Purdbull/Studienarbeit/Abschlussbild.png

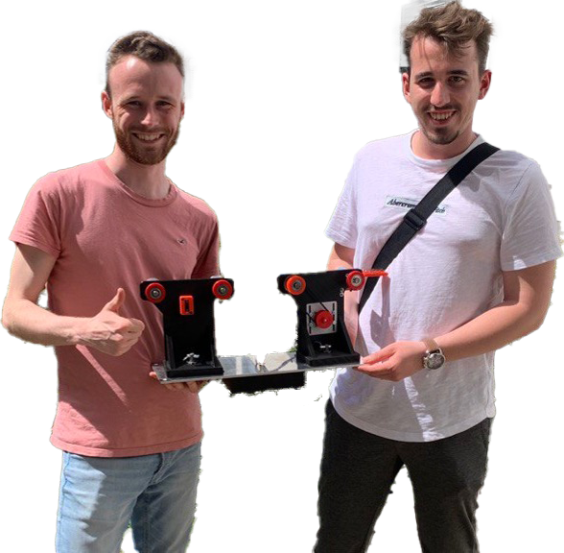
Abschlussbild.png
