Purdbull/Studienarbeit/PlakatStudienarbeitGartenhochbahn.pptx

Jan Bantle, Moritz Knapp

Bachelor – Studiengang
Mechatronik

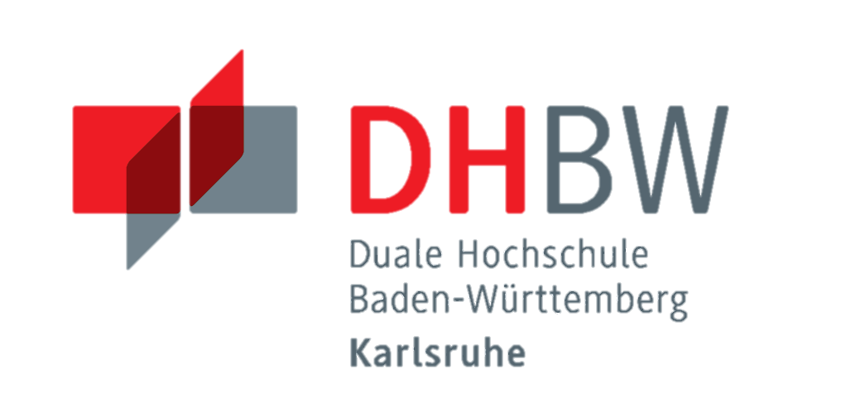
[picture p2: figure]

Digitalisierung einer Gartenhochbahn

Interdisziplinäre Studienarbeit: mechatronics meets informatics

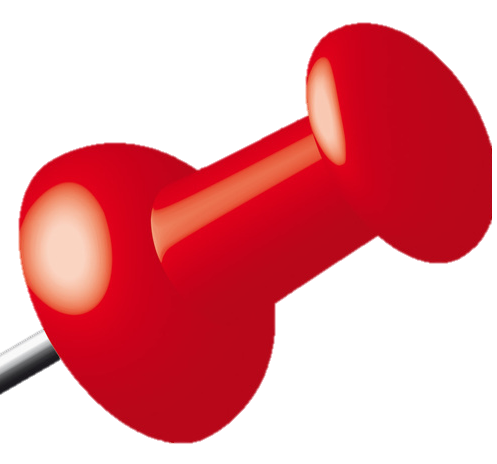
[picture p3: figure]
Alco reißnagel 1 cm Stahl rot 40 Stück

- Stromversorgung über Li-Ion-Batterie mit automatisiertem Lademanagement
- Antrieb mit Schrittmotor macht präzise Fahrprofile sowie Open-Loop-Regelung möglich
- Steuerung der Hochbahn über Webserver mit GUI
- Algorithmus zur streckenabhängigen Geschwindigkeitsregelung
- Überwachung von Warn- und Schutzfeld führt zu dynamischer Geschwindigkeitsanpassung

Highlights

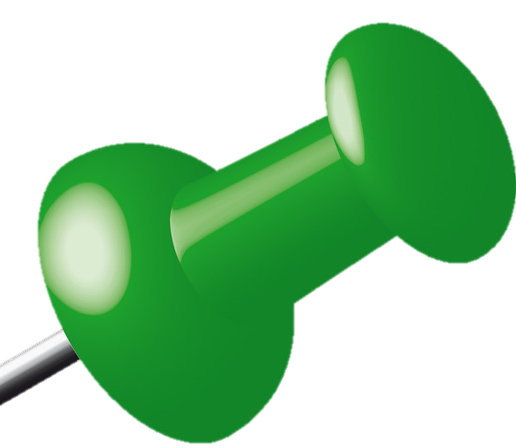
[picture p4: figure]
Alco reißnagel 1 cm Stahl grün 40 Stück

Sensorik & Aktorik

Positionserfassung & Distanzmessung

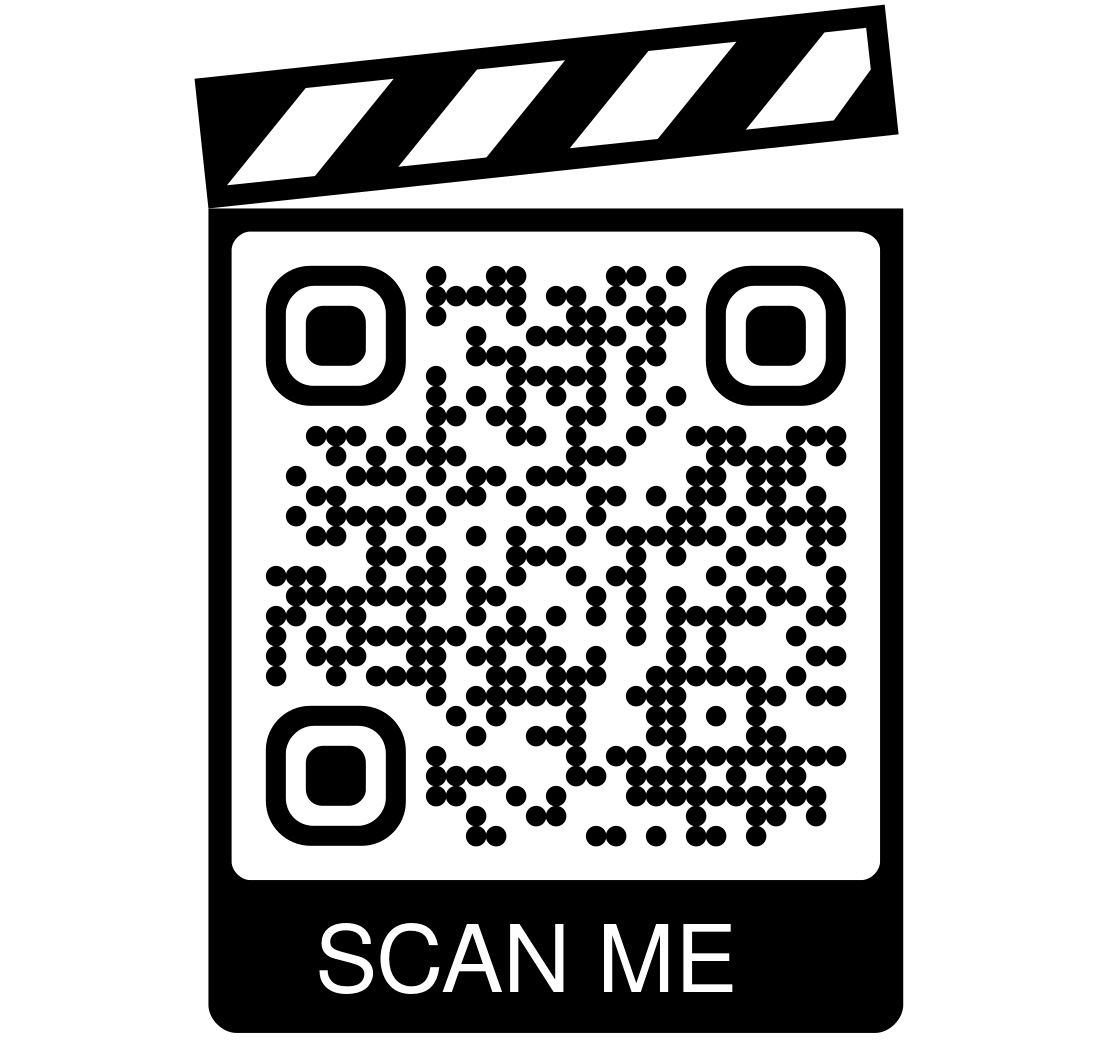
[picture p5: figure]
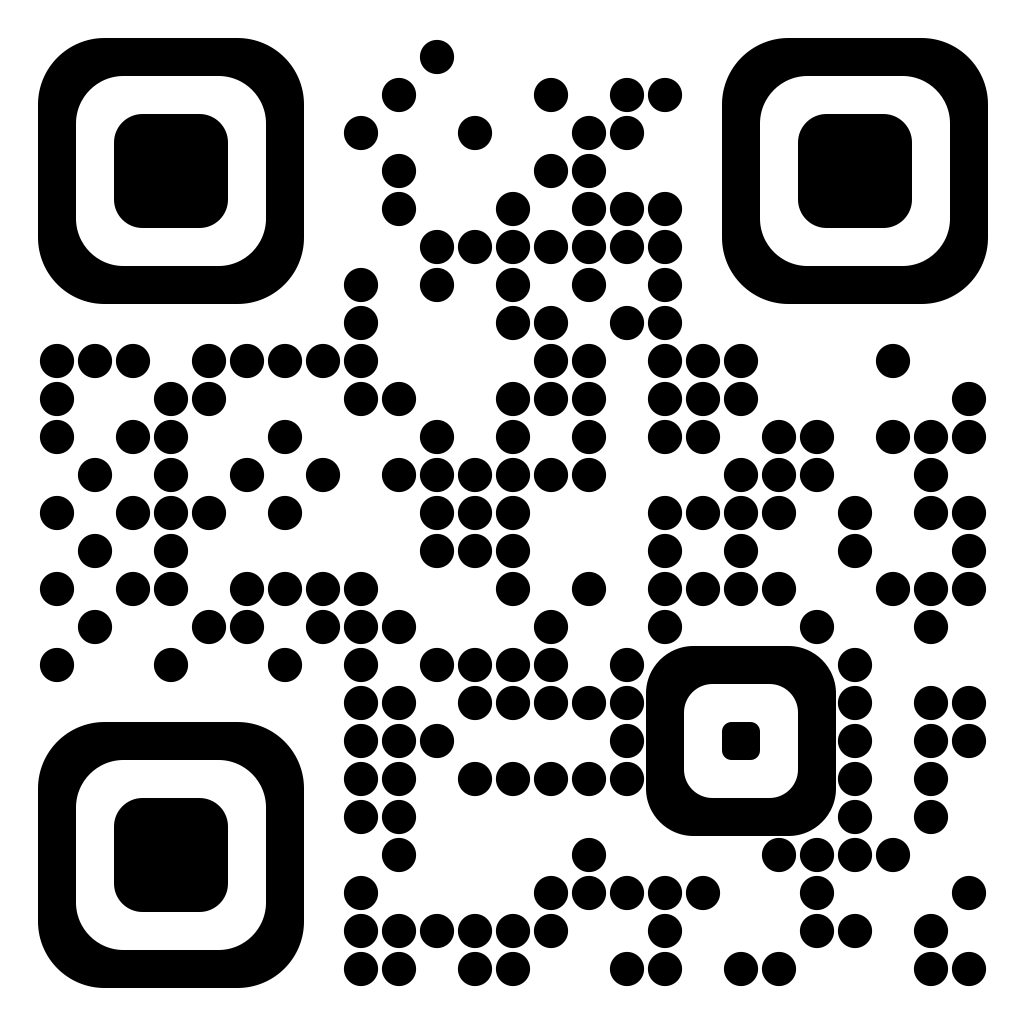
[picture p6: figure]
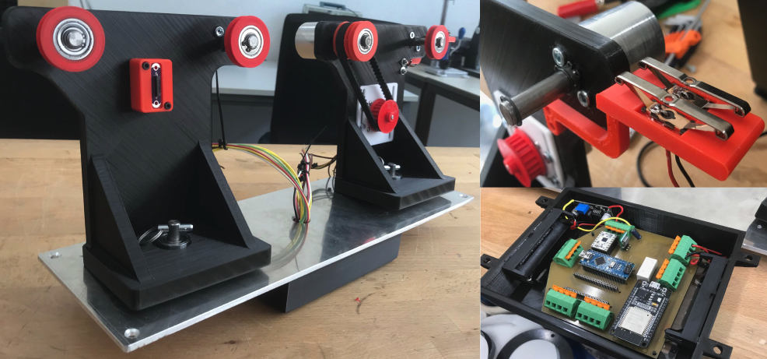
[picture p7: figure]

Erzeugen eines PWM-Signals über das Interrupt-Timer Register

Schrittmotorsteuerung

Mithilfe eines Reed-Kontakts werden Magnete entlang der Bahn erfasst.

Ein ausgelagerter Controller wertet die Signale der Ultraschallsensoren aus

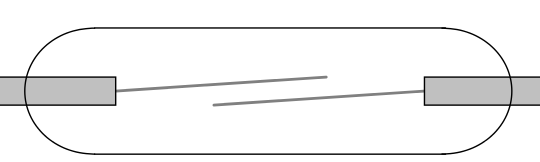
[picture p8: figure]
Der Strippenstrolch - Der Reedkontakt
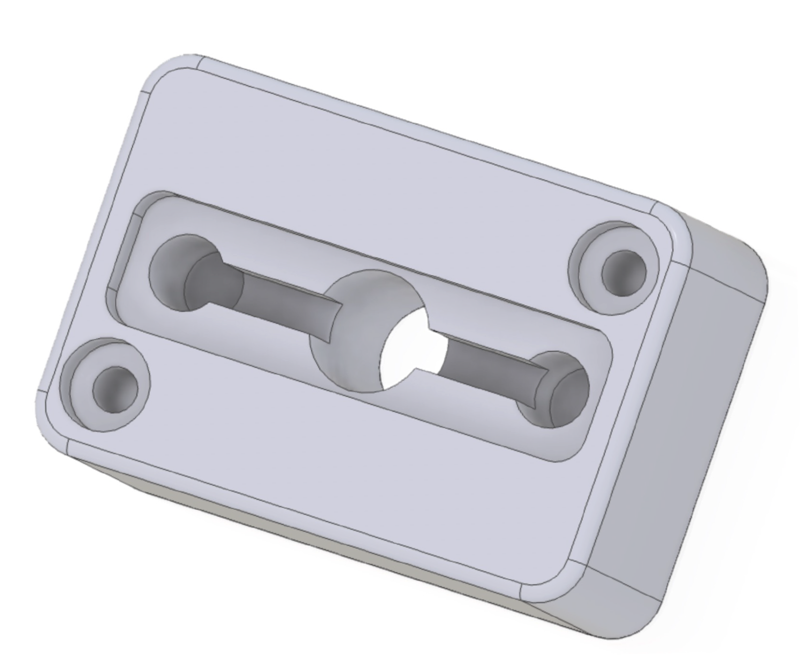
[picture p9: figure]
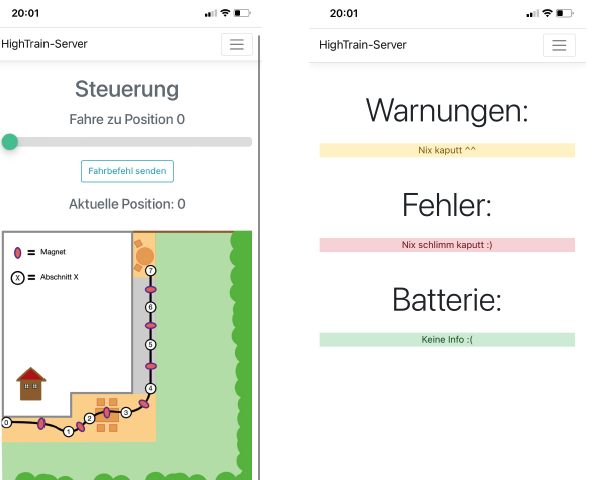
[picture p10: figure]

Grafische Benutzeroberfläche

Software

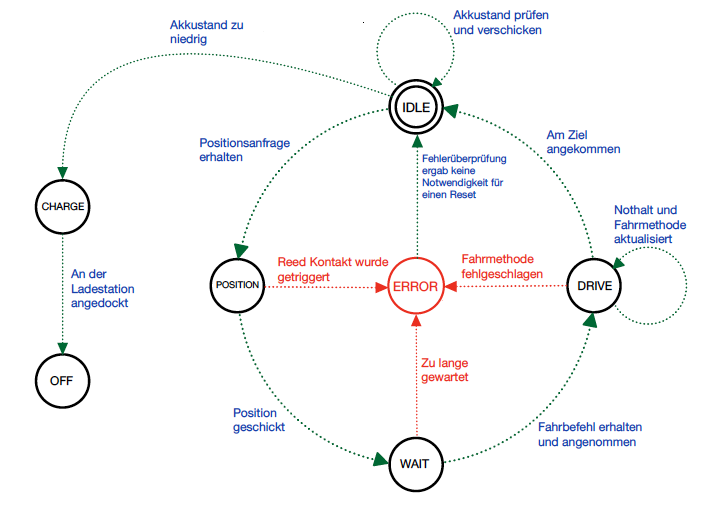
[picture p11: figure]

Zustandsautomat Hauptsteuerung

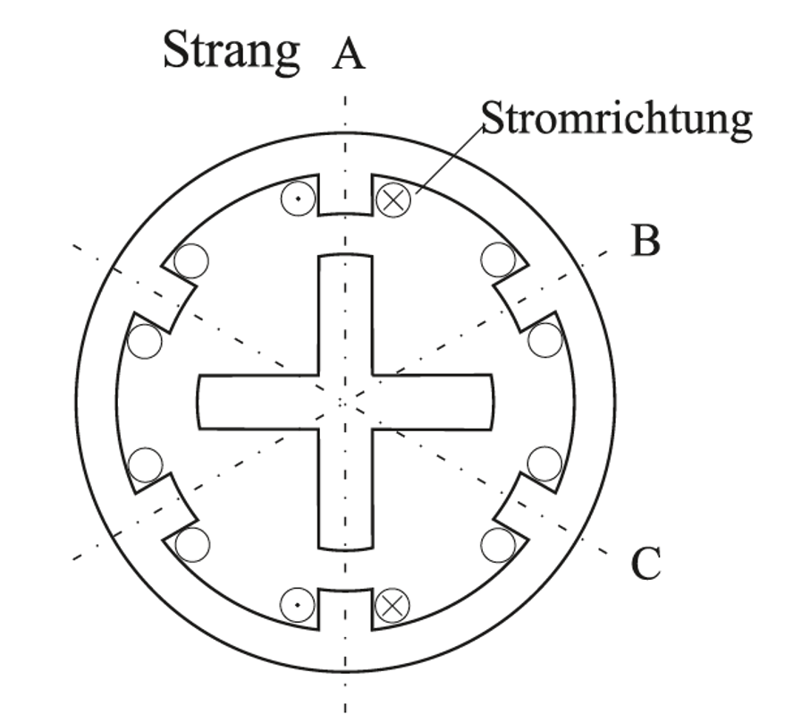
[picture p12: figure]
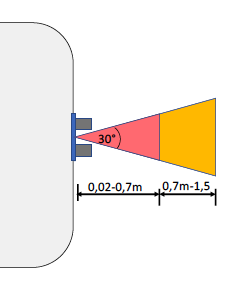
[picture p13: figure]

Betreuer
Dominik Weickgenannt

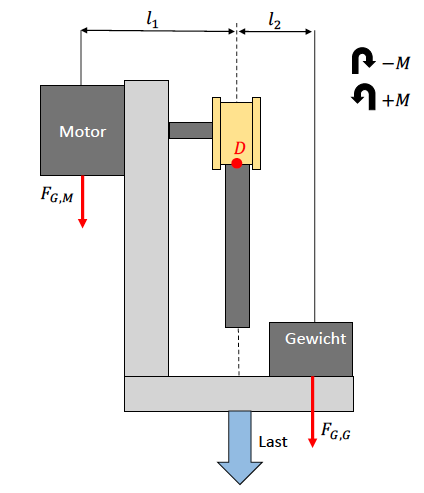
[picture p14: figure]

Konzeptionierung

Mechanik

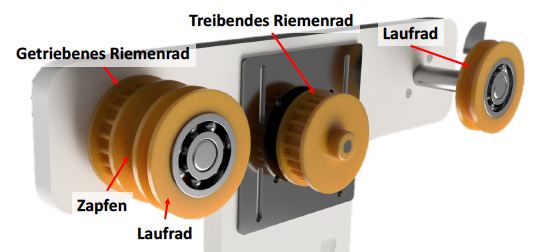
[picture p15: figure]

Fertigung

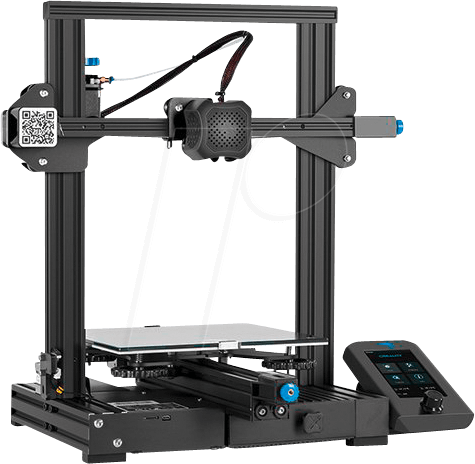
[picture p16: figure]

zerspanend

Schnittstellen

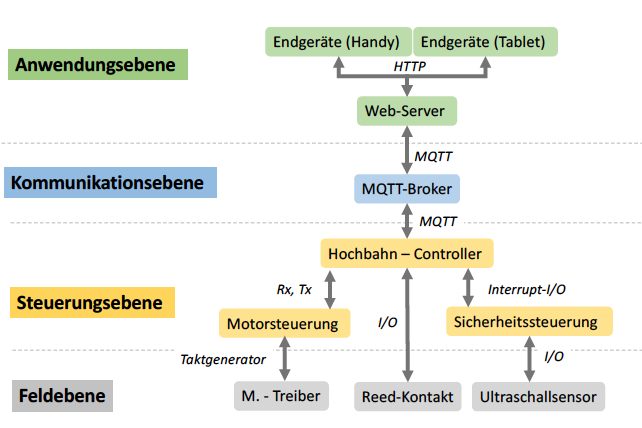
[picture p17: figure]
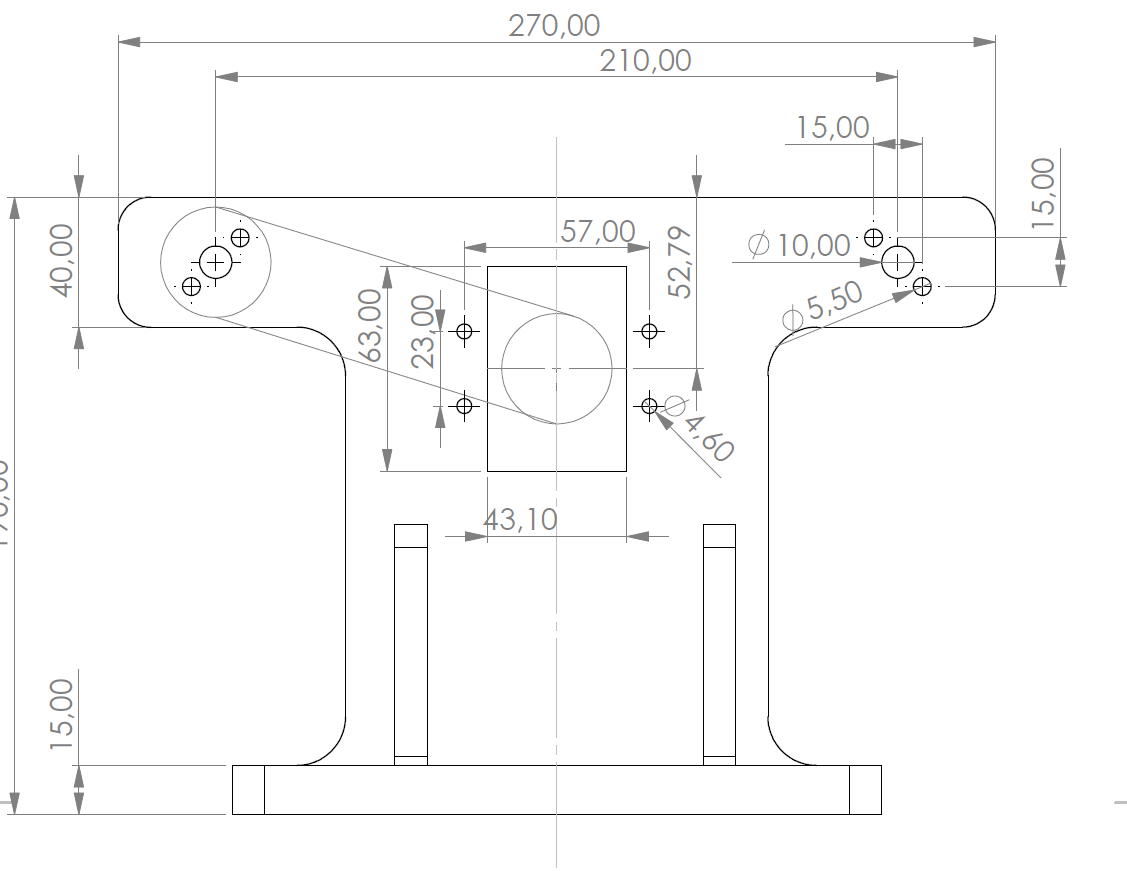
[picture p18: figure]

CAD - Entwurf

additiv

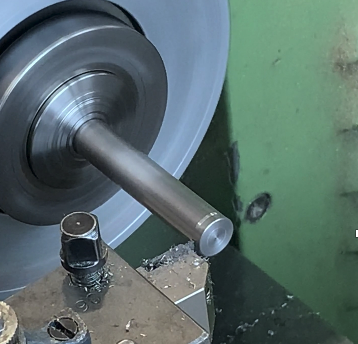
[picture p19: figure]

Fakultät

Technik

02.06.2022
