Purdbull/Studienarbeit/0_Projektorga/MeetingWeickgenannt_04_06.pptx

## Meeting Gartenhochbahn

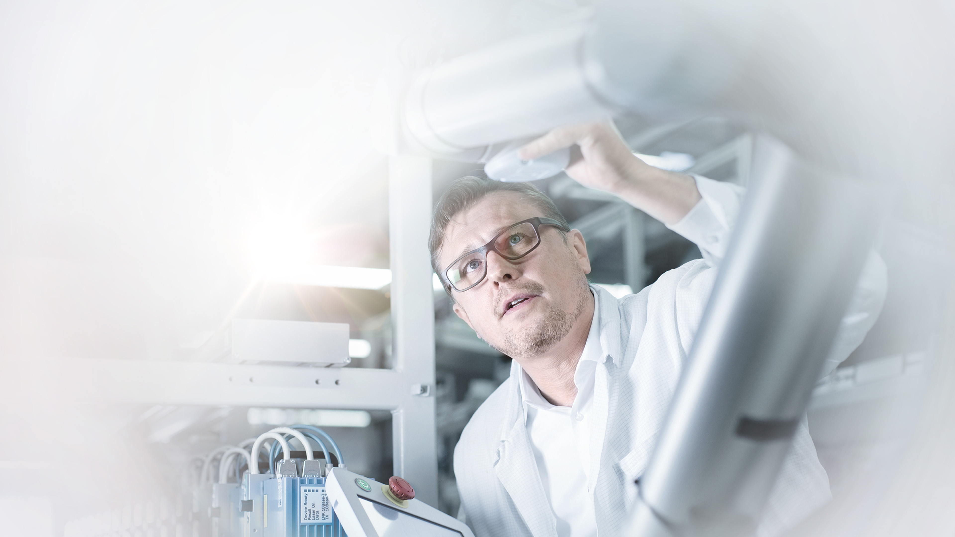
[picture p20: figure]

Moritz Knapp, Jan Bantle
05.04.2022

## 1. Entwicklung der Motor-Library

Interrupt

Counter

Vergleichs-register

f

+

Interrupt

Main loop{
}

Interrupt

## 2. Entwicklung der Fahrfunktion

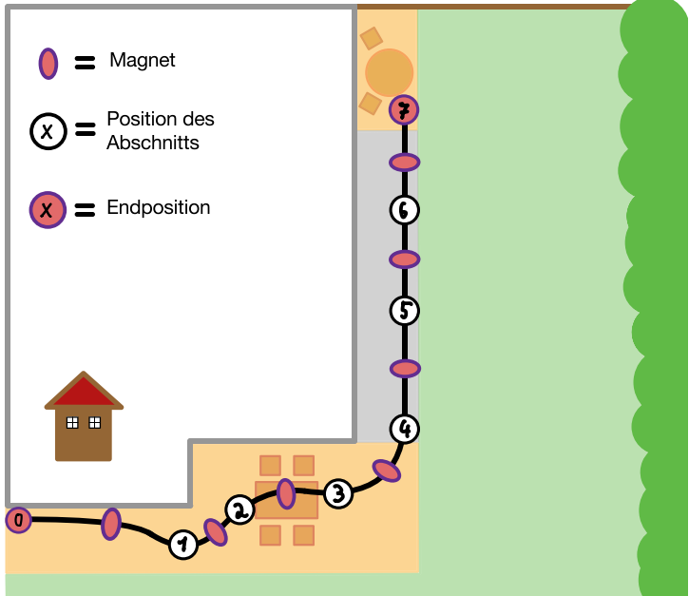
[picture p21: figure]

  - Für eine Fahrt von X nach Y gilt:
    - Die Geschwindigkeit in Abschnitt Y = 0
    - Die Geschwindigkeit im vorletzten Abschnitt max. 50%
    - Die Geschwindigkeit in Abschnitt X max. die Geschwindigkeit des 2. Abschnitts
    - Die restlichen Abschnitte ihre vordefinierte Geschwindigkeit

## Vielen Dank für Ihre Aufmerksamkeit.
