Purdbull/Studienarbeit/0_Projektorga/MeetingWeickgenannt_03_07.pptx

## Meeting Gartenhochbahn


Moritz Knapp, Jan Bantle
07.03.2022

## 1. Live-Demo: Informatik-Teil

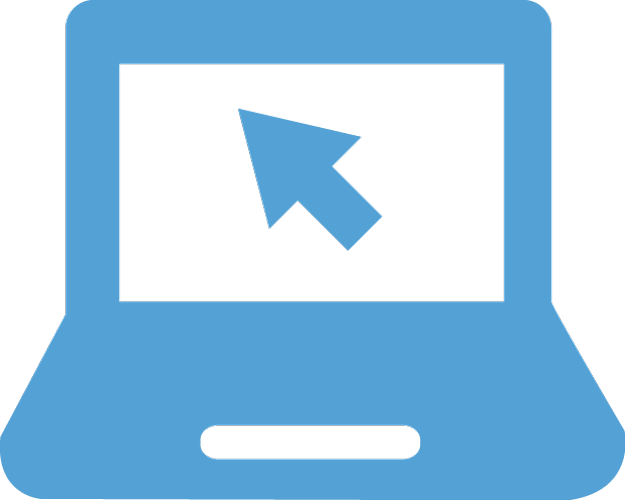
[picture p22: figure]

## Slide 3

2. Mechanischer Aufbau

- Elektronikbox
  - Konstruktion und Fertigung
- Unterbodenplatte und Drehgelenk
  - Konstruktion und Fertigung

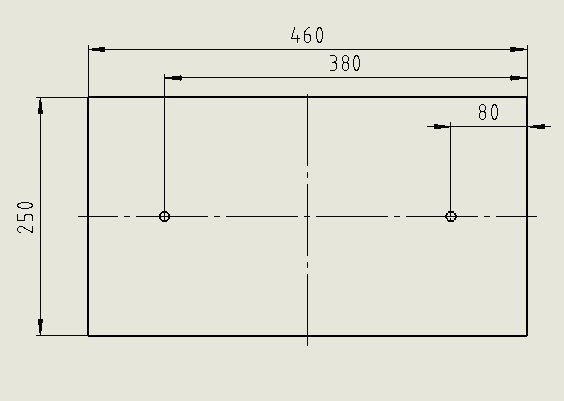
[picture p23: figure]
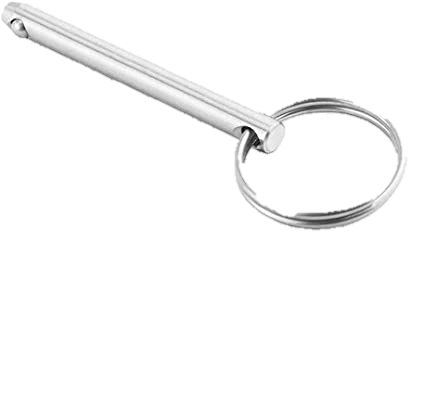
[picture p24: figure]
2 Pcs. Universal Steckbolzen mit Kugelsicherung, 316 Edelstahl : Amazon.de: Sport &amp;amp; Freizeit

Steckbolzen

Unterbodenplatte

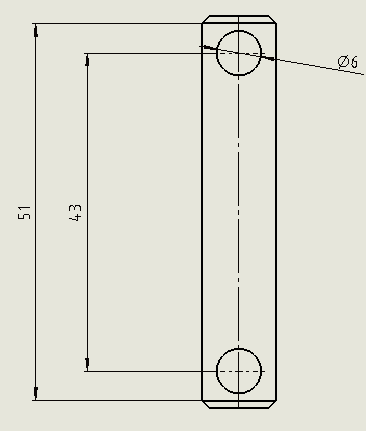
[picture p25: figure]
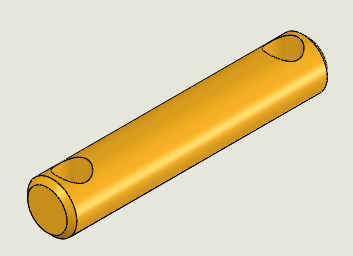
[picture p26: figure]

Gelenkbolzen

## Slide 4

2. Mechanischer Aufbau

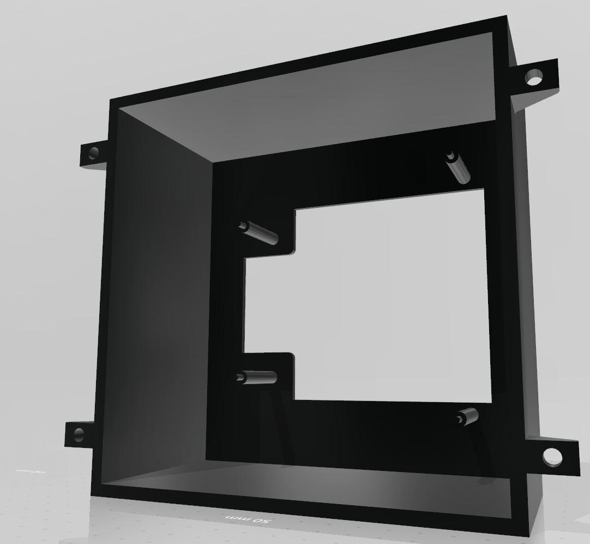
[picture p27: figure]

- Elektronikbox
  - Konstruktion und Fertigung
- Unterbodenplatte und Drehgelenk
  - Konstruktion und Fertigung

Befestigungsbolzen für Platine

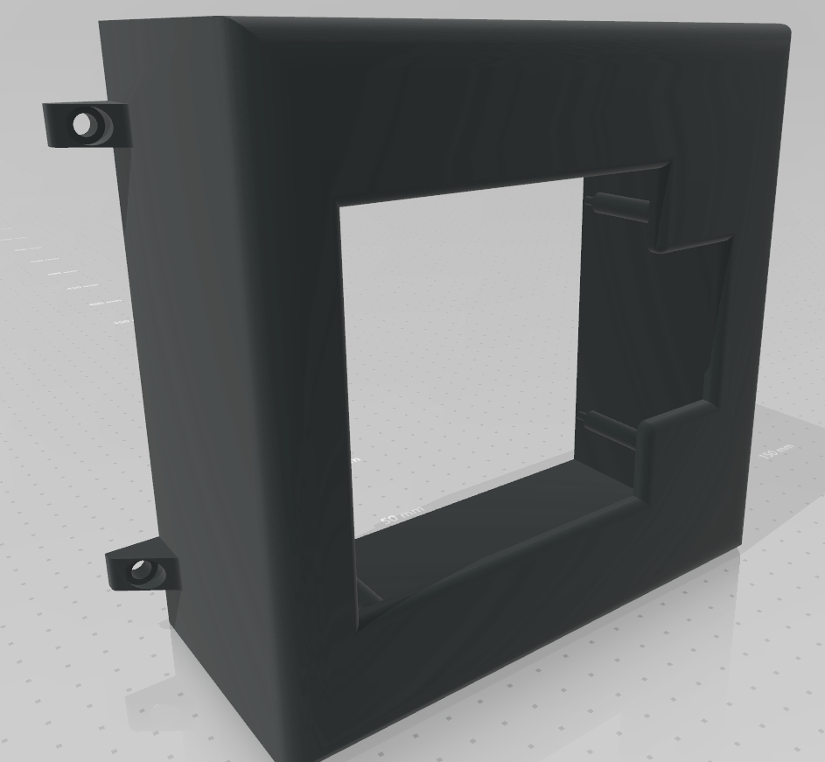
[picture p28: figure]

Plexiglas-Aussparung

Elektronikbox

## Slide 5

3. Motorsteuerung

- Schreiben eigener Stepper Library
  - Stepper-Takt über interne Arduino Timer
  - Inputsignal: speed (+/-) [%]
    - Automatisierte Beschleunigungskurve durch die Library
    - Bei 0%: Automatisiertes Wechseln über Voll- Halb und Viertelschritt → Für kontrollierten Stillstand (Lade- oder Übergabestation)
  - Weitere Funktion: EmergencyBrake

## Vielen Dank für Ihre Aufmerksamkeit.
