Purdbull/Studienarbeit/0_Projektorga/MeetingWeickgenannt_02_07.pptx

## Meeting Gartenhochbahn


Moritz Knapp, Jan Bantle
07.02.2022

## Slide 2

1. Mechanischer Aufbau

- Seitenteil
  - Anpassung der Maße an neue Riemenlänge
  - Additive Fertigung der Motofaufhängung
  - Additive Fertigung eines Prototypen
- Fertigung der Wellenaufnahme
- Neues Konzept für die axiale Fixierung der Welle
  - Fertigung der Wellen

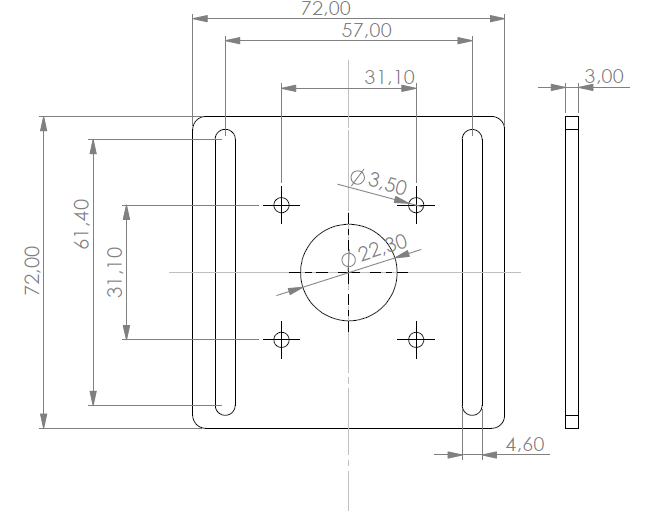
[picture p49: figure]

Seitenteil

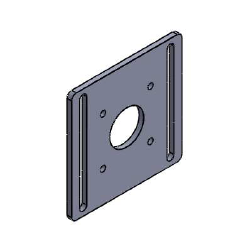
[picture p50: figure]

Motorbefestigung

## Slide 3

1. Mechanischer Aufbau

- Seitenteil
  - Anpassung der Maße an neue Riemenlänge
  - Additive Fertigung eines Prototpen
- Fertigung der Wellenaufnahme
- Neues Konzept für die axiale Fixierung der Welle
  - Fertigung der Wellen

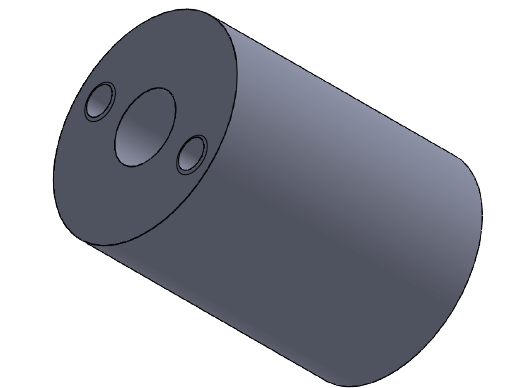
[picture p51: figure]
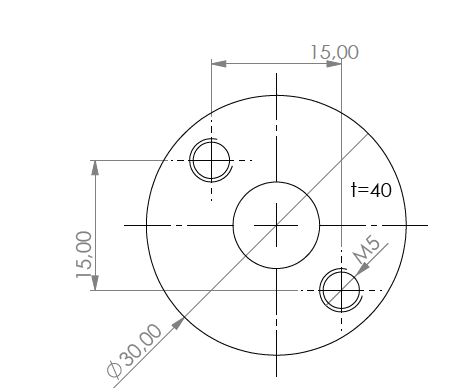
[picture p52: figure]

## Slide 4

1. Mechanischer Aufbau

- Seitenteil
  - Anpassung der Maße an neue Riemenlänge
  - Additive Fertigung eines Prototpen
- Fertigung der Wellenaufnahme
- Neues Konzept für die axiale Fixierung der Welle
  - Fertigung der Wellen

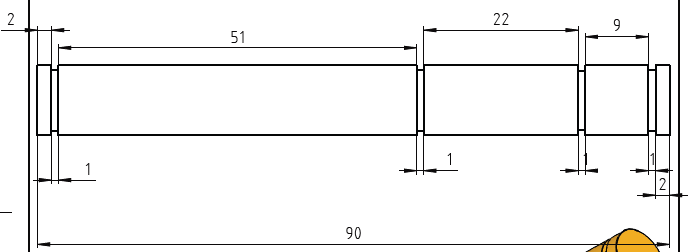
[picture p53: figure]
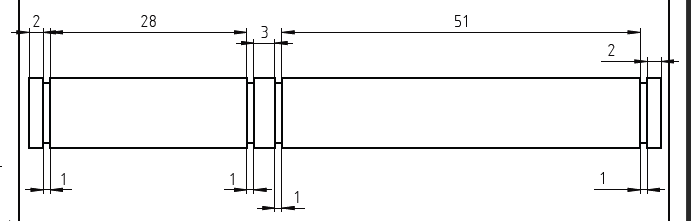
[picture p54: figure]
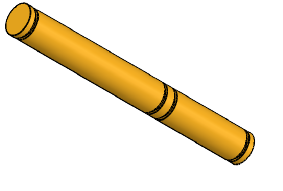
[picture p55: figure]
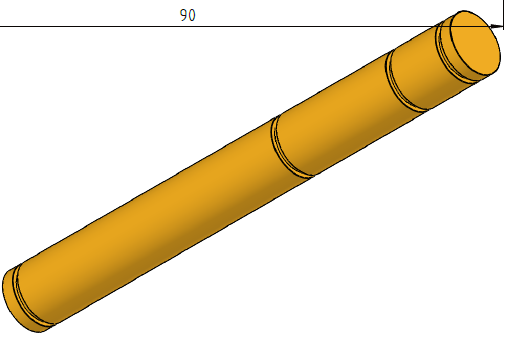
[picture p56: figure]
