Purdbull/Studienarbeit/2_CAD/Konzept I/3D-Ansicht oben .png

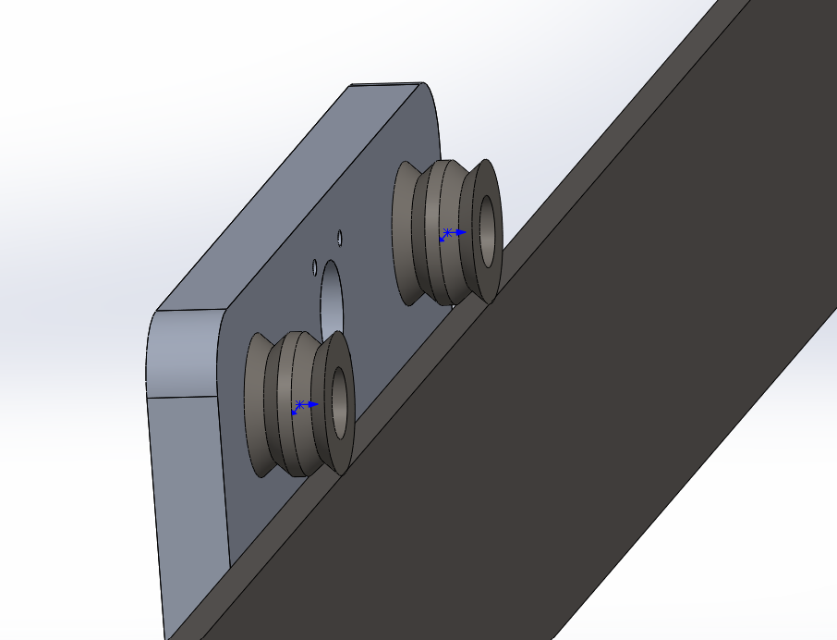
2_CAD/Konzept I/3D-Ansicht oben .png
