Purdbull/Studienarbeit/2_CAD/Konzept I/Gesamtaufnahme.png

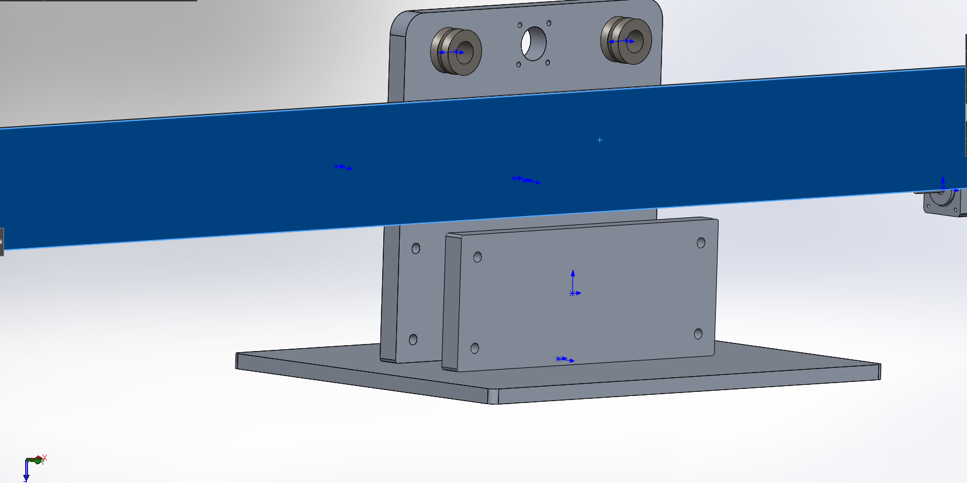
2_CAD/Konzept I/Gesamtaufnahme.png
