Purdbull/Studienarbeit/2_CAD/Konzept I/Seitenansicht.png

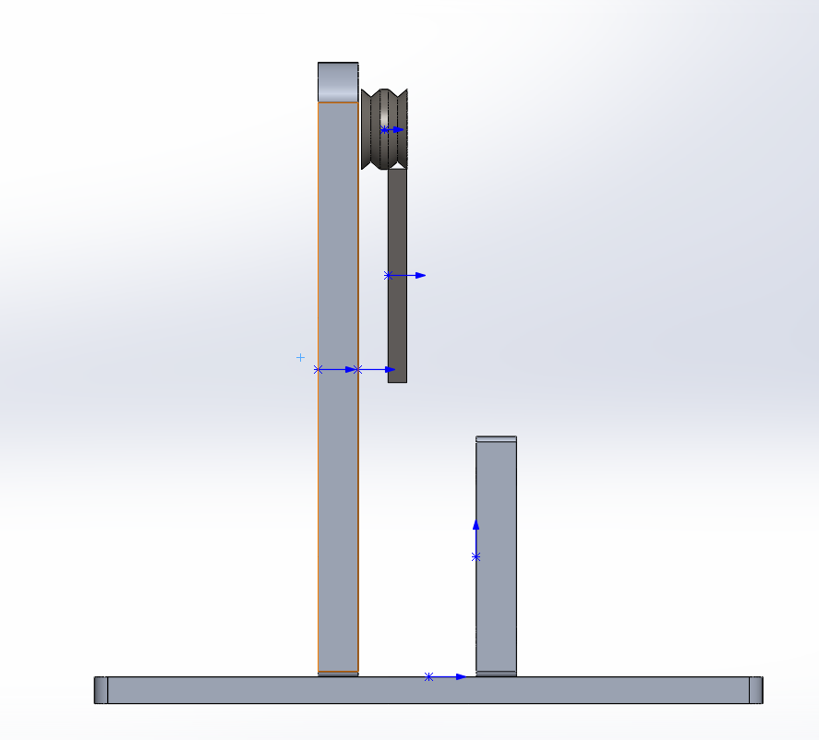
2_CAD/Konzept I/Seitenansicht.png
