Purdbull/Studienarbeit/Software/server/Server 1.0/Server 1.0/wwwroot/images/Streckengrafik.PNG

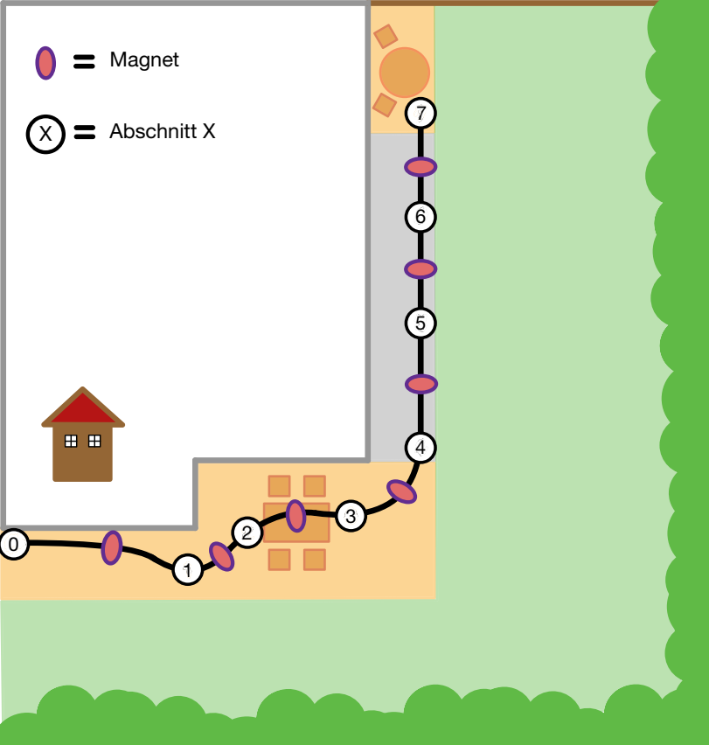
Software/server/Server 1.0/Server 1.0/wwwroot/images/Streckengrafik.PNG
