Purdbull/Studienarbeit/1_Material/AuswahlSchrittmotor.xlsx

Hersteller | Bezeichnung | Phasenstrom [A] | Spannung [V] | Leistung mech. [W] | Leistung max. [W] | Halte- moment | Drehmoment @45 U/s [mNm] | Drehzahl 1/s @145mNm | V @145mNm [km/h] | Preis | Bauform | Link | Driver
Joy-IT | Nema 14-2 | 0.75 | 4.35 | 3.26 | 4.73 | 150mNm | 130 | 3.333333333 | 0.42 | 13.99 | 35x35x35 | Pollin (https://www.pollin.de/p/joy-it-schrittmotor-nema14-02-1-80-2-phasen-4-35-v-0-15-nm-310800) | 2H-422 | 180g | 1400 rpm
Joy-IT | Nema 11 | 0.67 | 6.5 |  |  | 55NmN |  |  |  |  | 28x28x52 |  |  |  | 3000rpm
Joy-IT | Flat |  |  |  |  | 16mNm
Joy-IT | Nema 17-2 | 1.68 | 2.8 | 4.70 |  | 431 mNm |  |  |  |  | 42x42x47 |  |  | 365g | doppelkeule
Joy-IT | Nema 17-3 | 1.2 | 4.8 | 5.76 |  | 120 mNm |  |  |  |  | 42x42x27 |  |  | 150g
Joy-IT | Nema 23 | 2.5 | 3 | 7.50 |  | 120 mNm |  |  |  |  | 56x56x56 |  |  | 560g
Pollin | PSM42BYGHW603 | 0.4 | 12 | 4.80 |  | 380 mNm | 22.25 | n.P. | n.P. |  | 42
 | Nema 17-4 | 1.5 | 3.3 | 4.95 |  | 450 mNm |  | 13.5 | 1.458 |  | 42x42x42
i | 2.5
v_modell | 3.645
v_real | 116.64
