Purdbull/Studienarbeit/2_CAD/Konzept I/Triebwagen.SLDASM

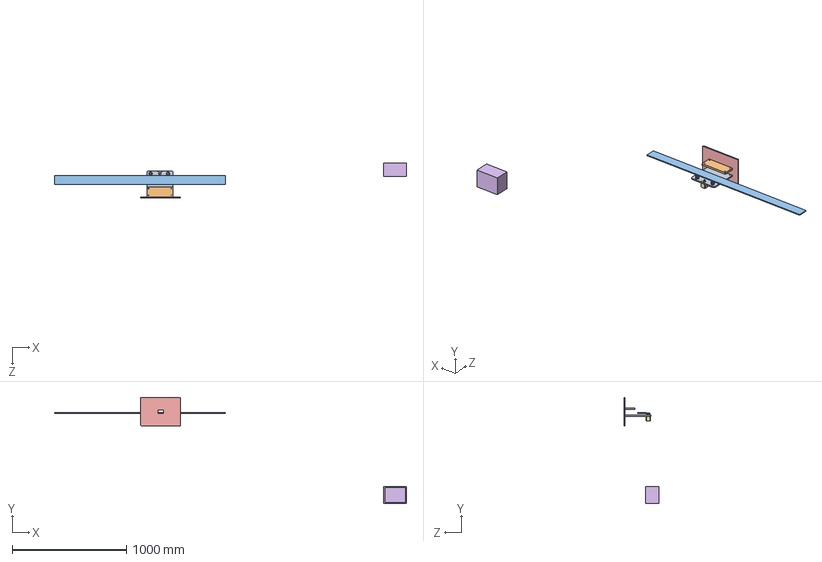
[picture p61: CAD file, 2021-10-31]
2_CAD/Konzept I/Triebwagen.SLDASM
3084.2 x 931.7 x 310.3 mm
Seitenteil_A
Seitenteil_B
Schiene
Riemenscheibe_Dummy x 2
Unterbodenplatte
Steuerungsbox_dummy
Nema 17-04
