Purdbull/Studienarbeit/2_CAD/Konzept II/Triebwagen_V2.SLDASM

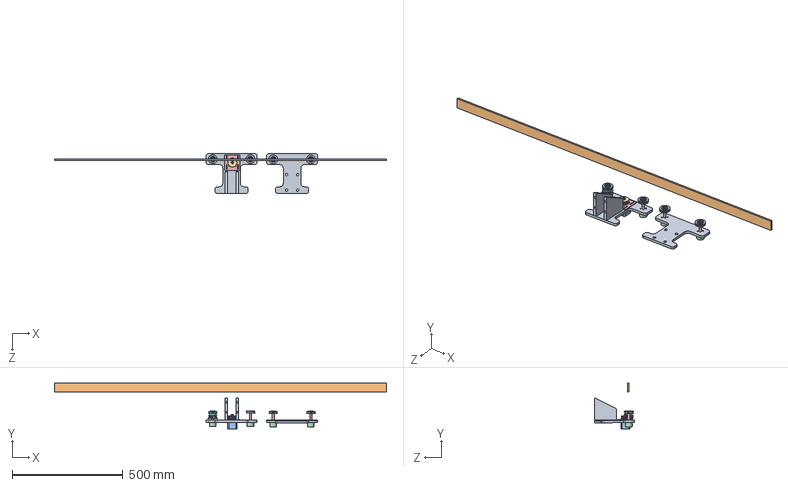
[picture p62: CAD file, 2021-11-25]
2_CAD/Konzept II/Triebwagen_V2.SLDASM
1500.0 x 206.8 x 180.2 mm
Seitenteil_B x 2
Nema 17-04
Wellenaufnahme x 4
Welle x 4
Laufrad v6.step x 3
ZahnradMotor v2.step
ZahnRiemenRad v6.step
Verbindungsdreieck x 2
_SKF_6000_PART1.stp x 4
_SKF_6000_PART2.stp x 4
_SKF_6000_PART3.stp x 28
Motorbefestigung
