Purdbull/Studienarbeit/1_Material/DataSheets/reg26a-drill.dxf

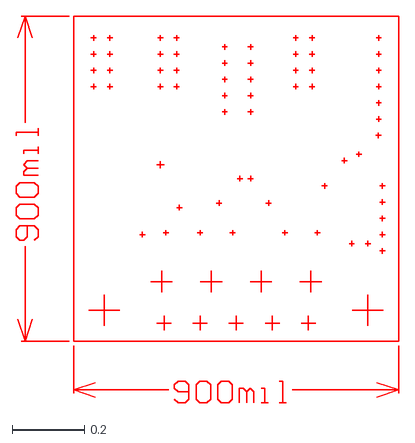
[picture p63: CAD file, 2022-01-13]
1_Material/DataSheets/reg26a-drill.dxf
1.06 x 1.07
