Purdbull/Studienarbeit/2_CAD/Konzept II/Box.SLDPRT

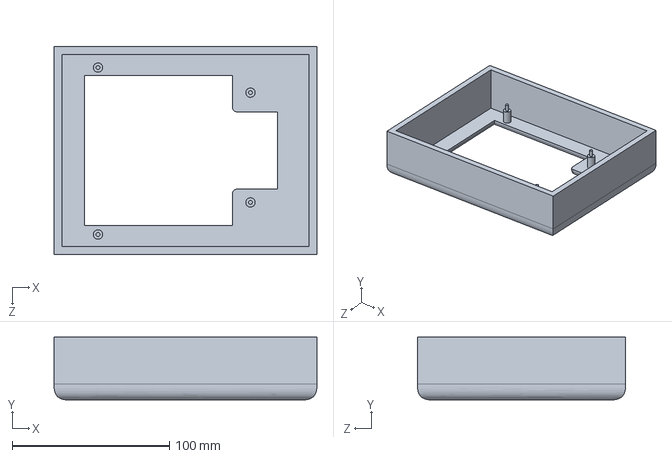
[picture p64: CAD file, 2022-03-08]
2_CAD/Konzept II/Box.SLDPRT
167.0 x 40.0 x 132.2 mm
