Purdbull/Studienarbeit/2_CAD/Konzept II/Getriebe/SKF_6000.stp

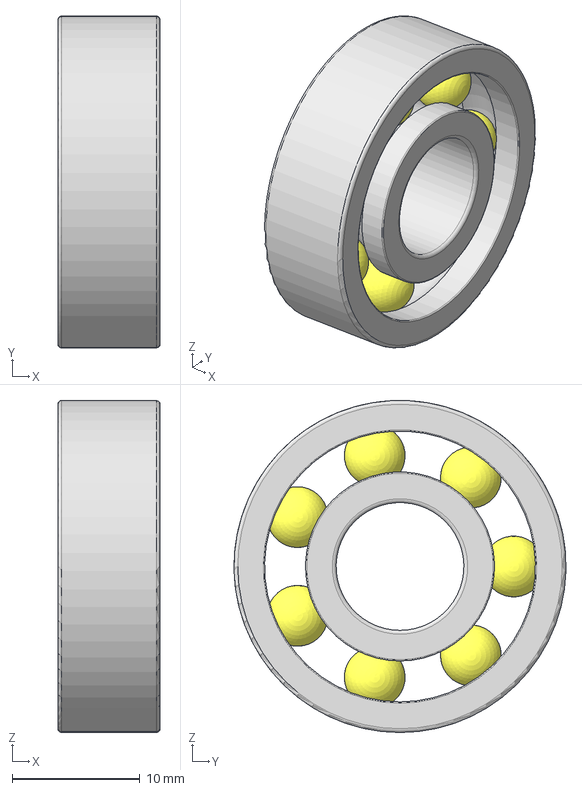
[picture p65: CAD file, 2021-11-25]
2_CAD/Konzept II/Getriebe/SKF_6000.stp
8.00 x 26.0 x 26.0 mm
_SKF_6000_PART1
_SKF_6000_PART2
_SKF_6000_PART3 x 7
_SKF_6000_PART4 x 7
