Purdbull/Studienarbeit/2_CAD/Konzept II/PrintData/reedKontaktHalter.3mf

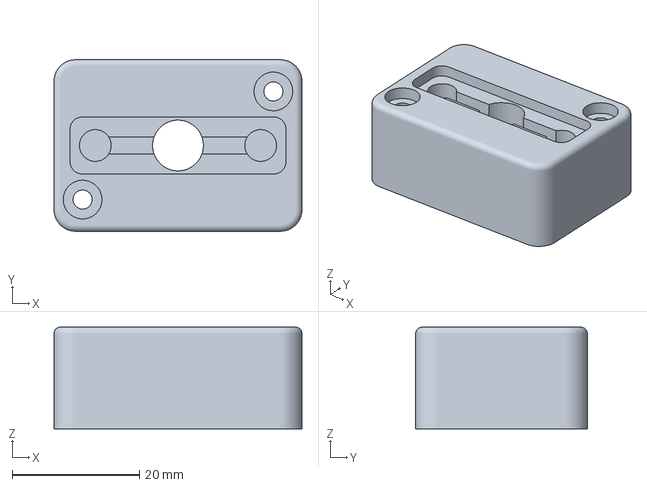
[picture p66: CAD file, 2022-05-09]
2_CAD/Konzept II/PrintData/reedKontaktHalter.3mf
39.0 x 27.0 x 16.0 mm
