Purdbull/Studienarbeit/2_CAD/Konzept I/Seitenteil_A.SLDPRT

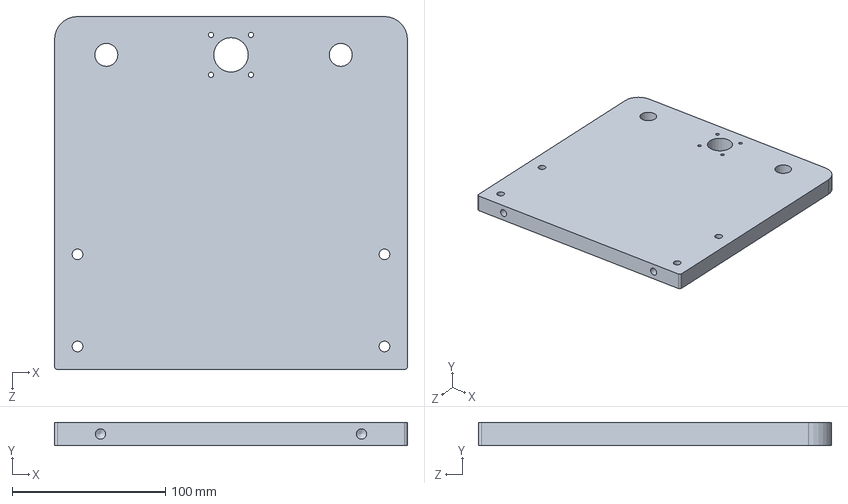
[picture p67: CAD file, 2021-10-31]
2_CAD/Konzept I/Seitenteil_A.SLDPRT
230.0 x 15.0 x 230.0 mm
