Purdbull/Studienarbeit/2_CAD/Konzept II/boxNeu.SLDPRT

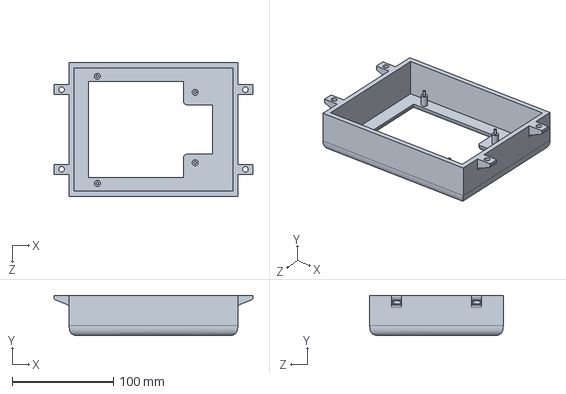
[picture p68: CAD file, 2022-03-08]
2_CAD/Konzept II/boxNeu.SLDPRT
197.0 x 40.0 x 132.2 mm
