Purdbull/Studienarbeit/2_CAD/Konzept II/Getriebe/Riemenrad_treibend.SLDPRT

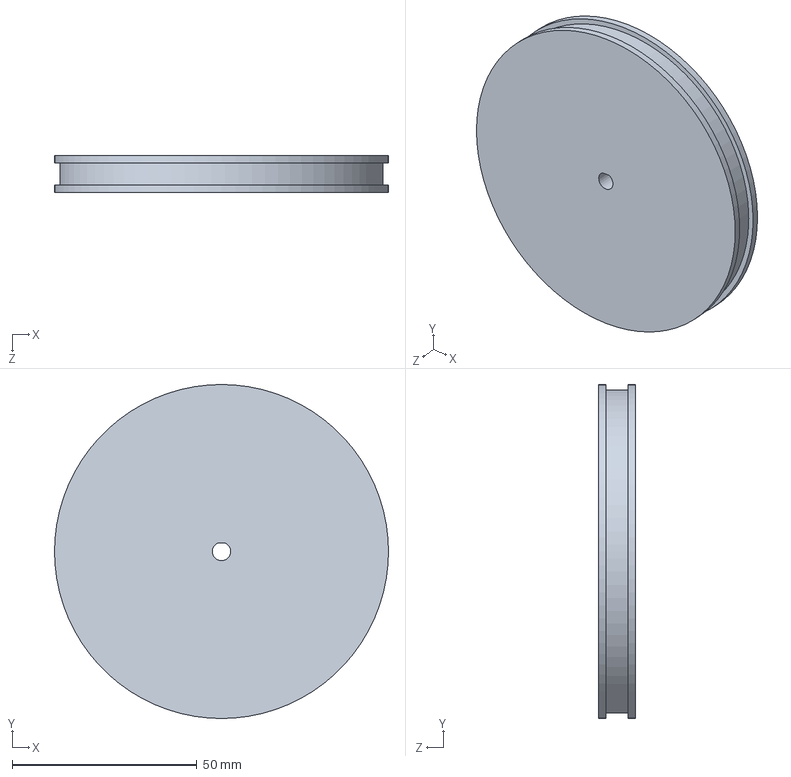
[picture p69: CAD file, 2021-11-08]
2_CAD/Konzept II/Getriebe/Riemenrad_treibend.SLDPRT
90.5 x 90.5 x 10.0 mm
