Purdbull/Studienarbeit/2_CAD/Konzept II/PrintData/CCR10SPRO_ladevorrichtung.3mf

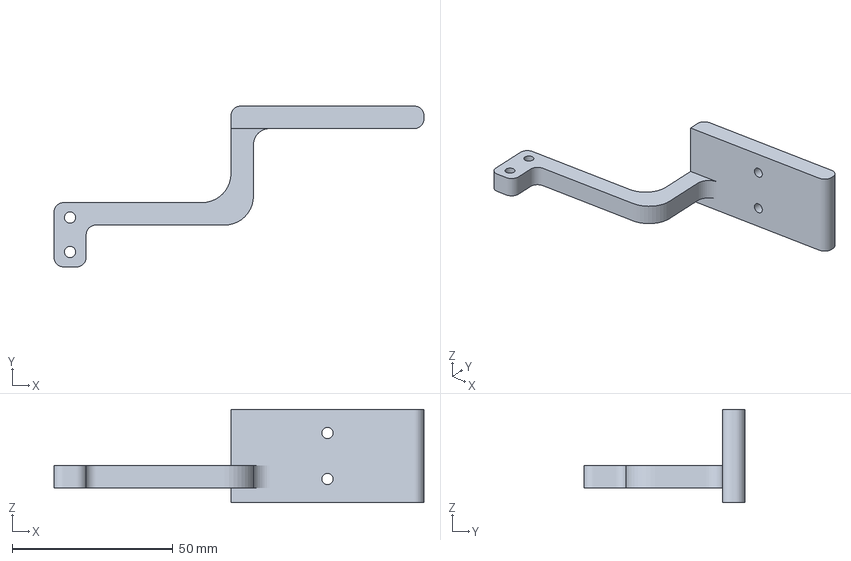
[picture p70: CAD file, 2022-05-09]
2_CAD/Konzept II/PrintData/CCR10SPRO_ladevorrichtung.3mf
115.0 x 50.0 x 29.0 mm
