Purdbull/Studienarbeit/2_CAD/Konzept II/STEP/ladevorrichtung.STEP

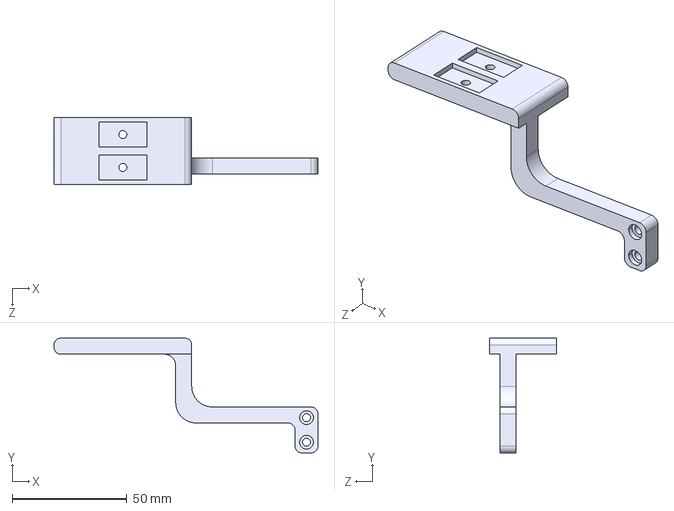
[picture p71: CAD file, 2022-05-03]
2_CAD/Konzept II/STEP/ladevorrichtung.STEP
115.0 x 50.0 x 29.0 mm
