Purdbull/Studienarbeit/2_CAD/Konzept I/Nema 17-04.SLDPRT

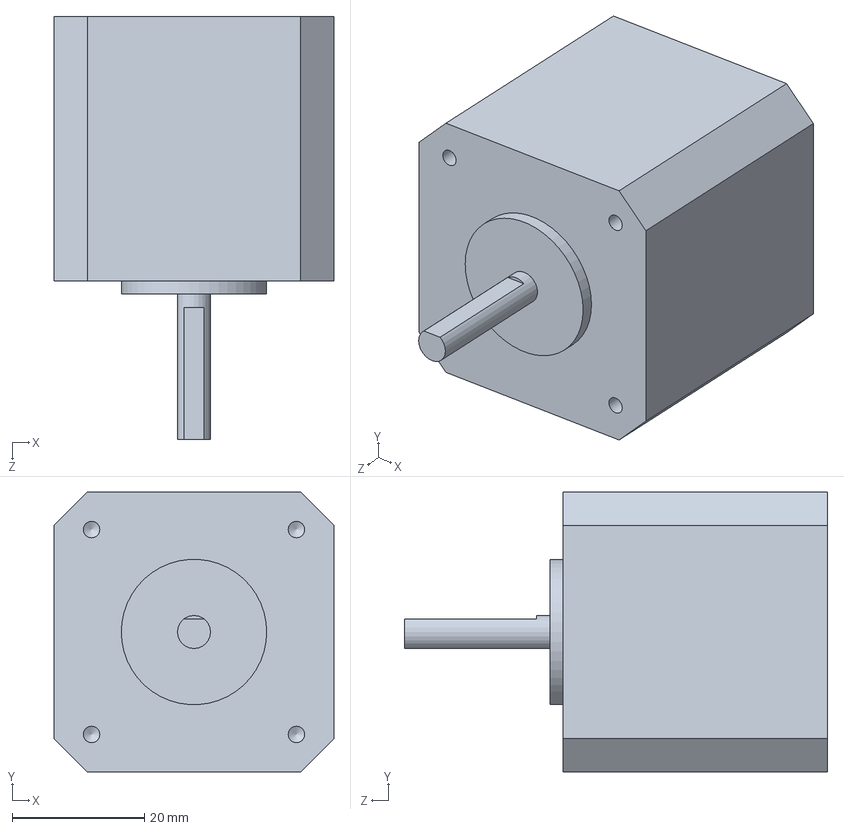
[picture p72: CAD file, 2021-10-31]
2_CAD/Konzept I/Nema 17-04.SLDPRT
42.3 x 42.3 x 64.0 mm
