Purdbull/Studienarbeit/2_CAD/Konzept II/Getriebe/Riemenrad_treibend_neu.SLDPRT

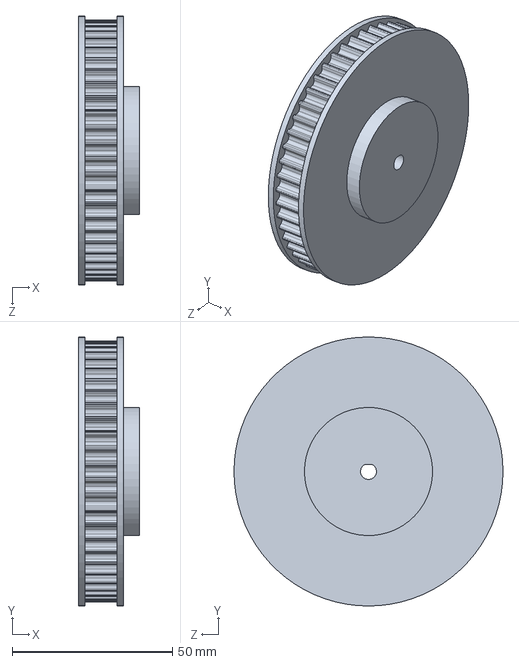
[picture p73: CAD file, 2021-11-08]
2_CAD/Konzept II/Getriebe/Riemenrad_treibend_neu.SLDPRT
19.0 x 84.0 x 84.0 mm
