Purdbull/Studienarbeit/2_CAD/Konzept II/Getriebe/Vorlagen/ZahnradMotor v5.step

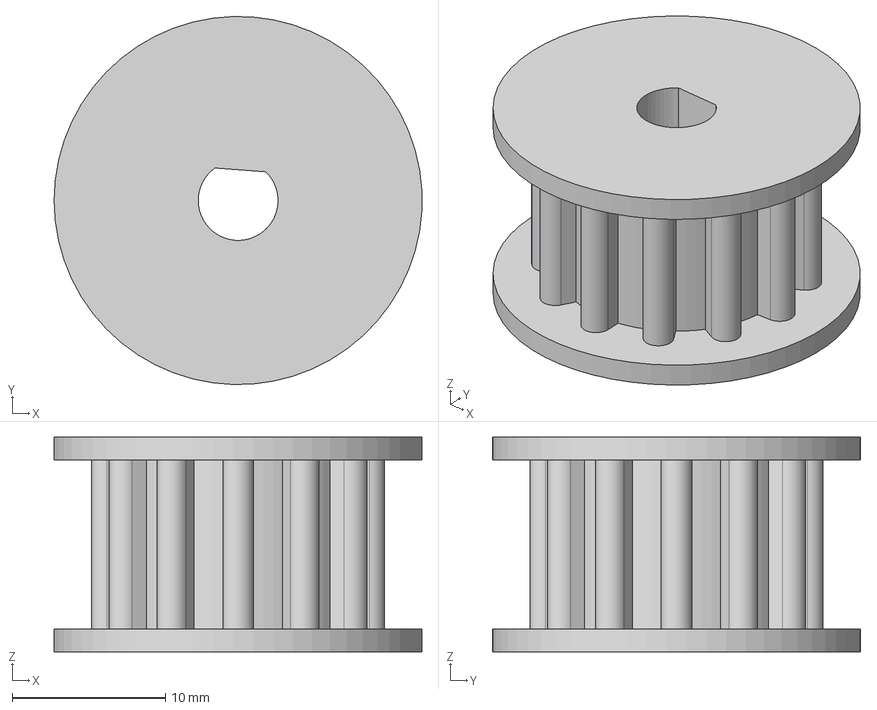
[picture p74: CAD file, 2021-11-22]
2_CAD/Konzept II/Getriebe/Vorlagen/ZahnradMotor v5.step
24.0 x 24.0 x 14.0 mm
