Purdbull/Studienarbeit/2_CAD/Konzept II/Seitenteil_A_SW2021.SLDPRT

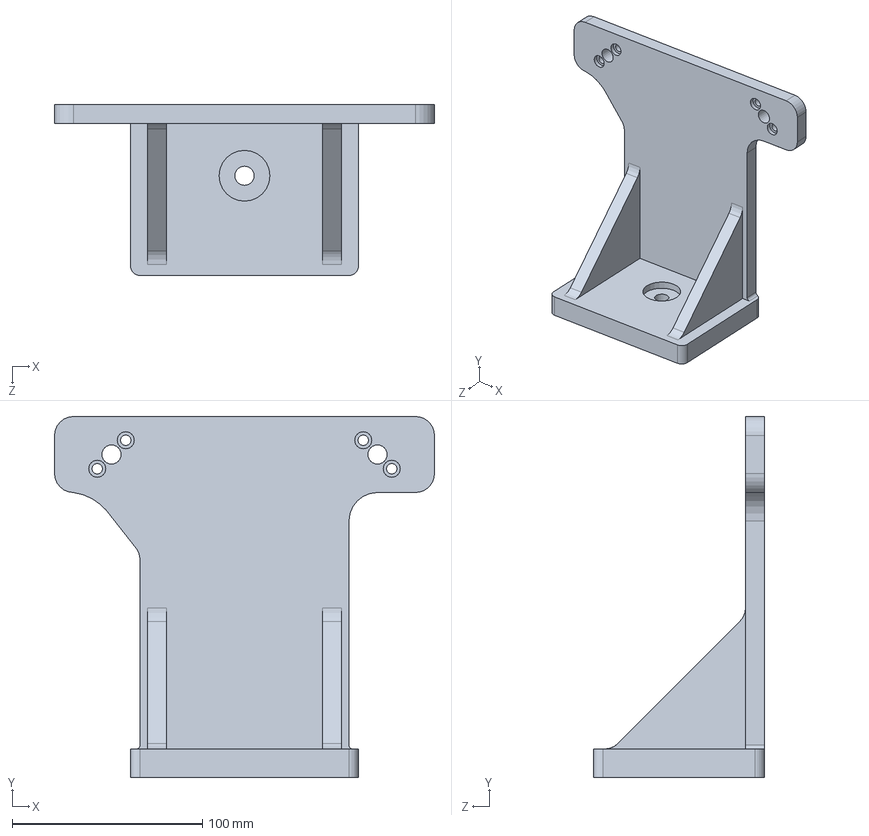
[picture p75: CAD file, 2022-02-25]
2_CAD/Konzept II/Seitenteil_A_SW2021.SLDPRT
200.0 x 190.0 x 90.0 mm
