Purdbull/Studienarbeit/2_CAD/Konzept I/Unterbodenplatte.SLDPRT

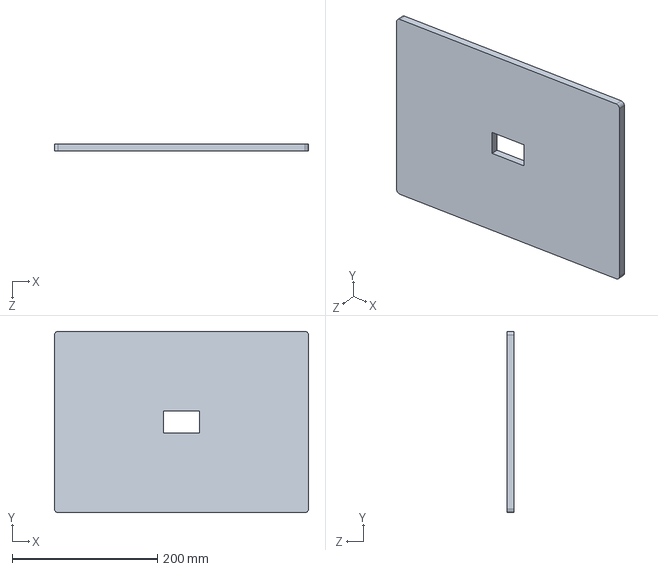
[picture p76: CAD file, 2021-10-27]
2_CAD/Konzept I/Unterbodenplatte.SLDPRT
350.0 x 250.0 x 10.0 mm
