Purdbull/Studienarbeit/2_CAD/Konzept II/PrintData/ZahnRiemenRad.3mf

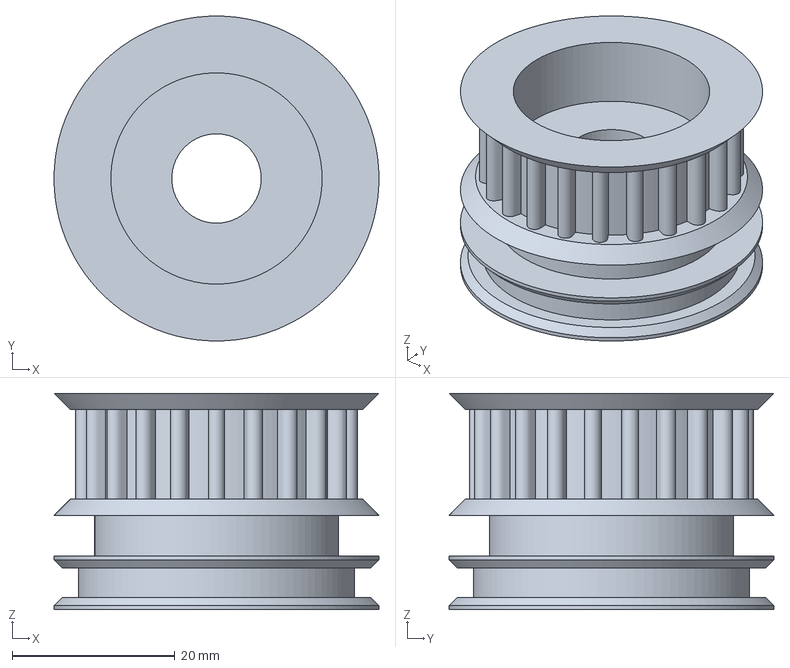
[picture p77: CAD file, 2022-05-09]
2_CAD/Konzept II/PrintData/ZahnRiemenRad.3mf
40.0 x 40.0 x 26.6 mm
