Purdbull/Studienarbeit/2_CAD/Konzept II/Verbindungsbolzen.SLDPRT

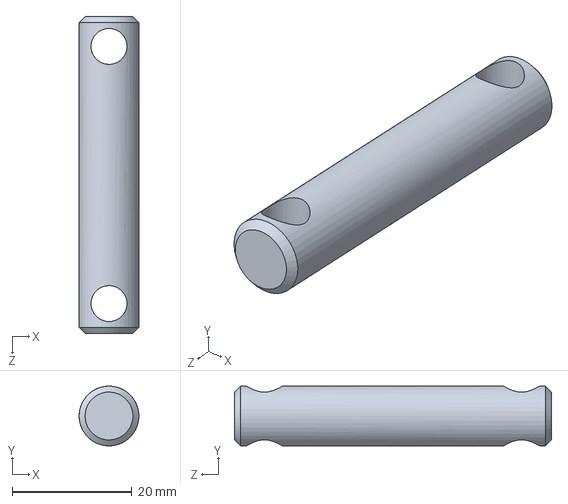
[picture p78: CAD file, 2022-02-22]
2_CAD/Konzept II/Verbindungsbolzen.SLDPRT
10.0 x 10.0 x 53.0 mm
