Purdbull/Studienarbeit/2_CAD/Konzept I/Seitenteil_B.SLDPRT

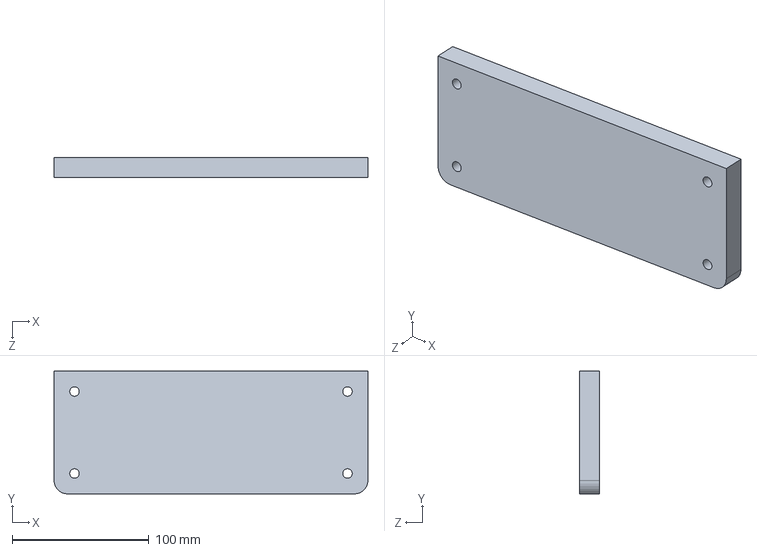
[picture p79: CAD file, 2021-10-27]
2_CAD/Konzept I/Seitenteil_B.SLDPRT
230.0 x 90.0 x 15.0 mm
