Purdbull/Studienarbeit/2_CAD/Konzept II/PrintData/ZahnradMotor v5.stl

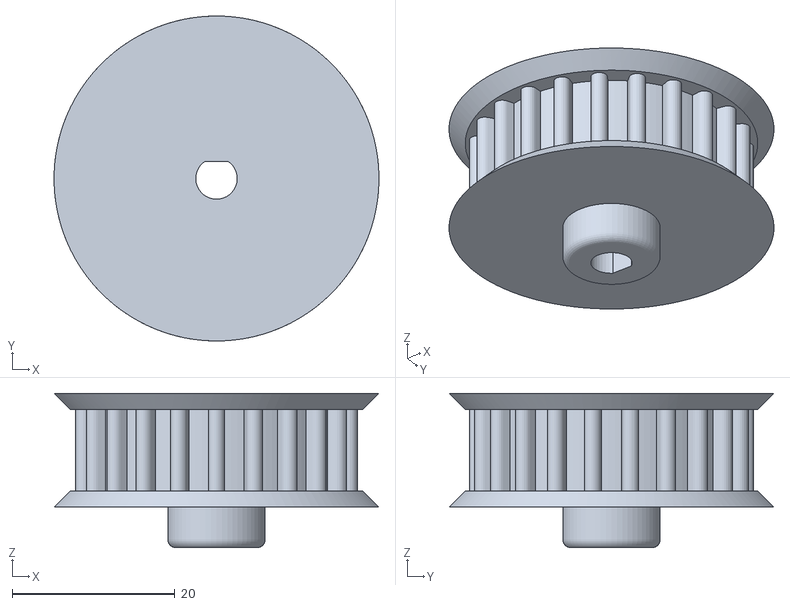
[picture p80: CAD file, 2022-03-07]
2_CAD/Konzept II/PrintData/ZahnradMotor v5.stl
40.0 x 40.0 x 19.0
