Purdbull/Studienarbeit/2_CAD/Konzept II/Unterbodenplatte2.SLDPRT

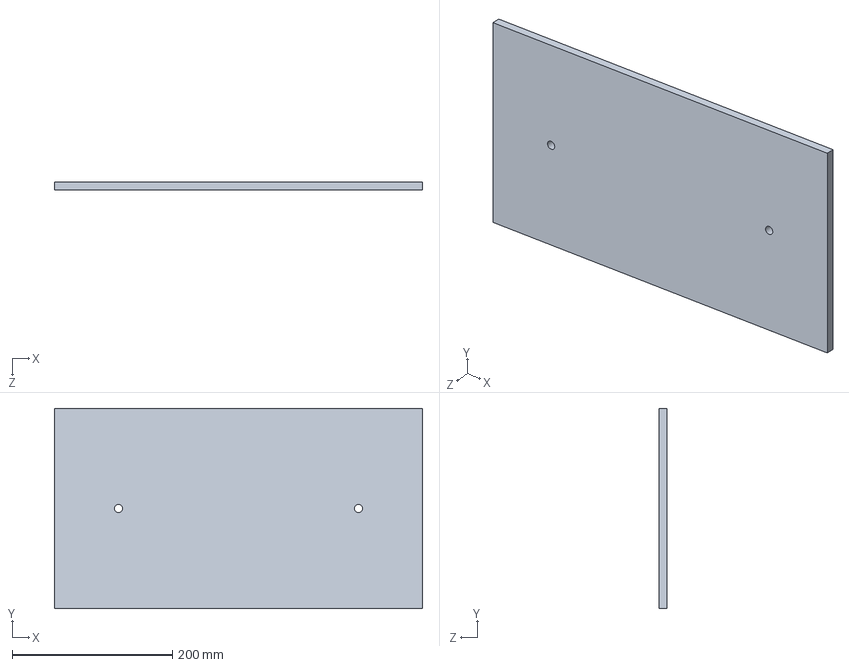
[picture p81: CAD file, 2022-02-22]
2_CAD/Konzept II/Unterbodenplatte2.SLDPRT
460.0 x 250.0 x 10.0 mm
