Purdbull/Studienarbeit/2_CAD/Konzept I/Schiene.SLDPRT

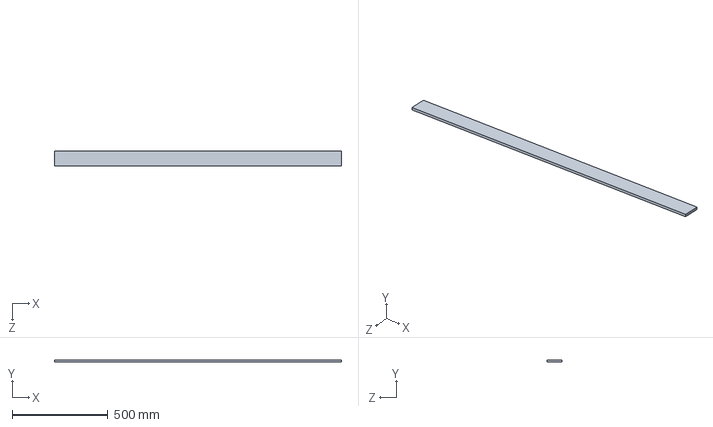
[picture p82: CAD file, 2021-10-27]
2_CAD/Konzept I/Schiene.SLDPRT
1500.0 x 12.0 x 80.0 mm
