Purdbull/Studienarbeit/2_CAD/Konzept II/Seitenteil_B_SW2021.STEP

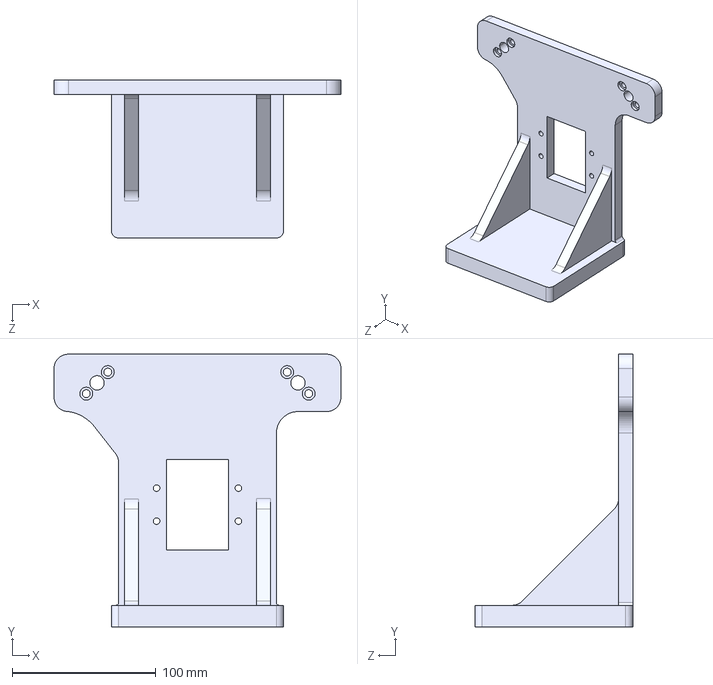
[picture p83: CAD file, 2022-02-14]
2_CAD/Konzept II/Seitenteil_B_SW2021.STEP
200.0 x 190.0 x 110.0 mm
