Purdbull/Studienarbeit/2_CAD/Konzept I/Riemenscheibe_Dummy.SLDPRT

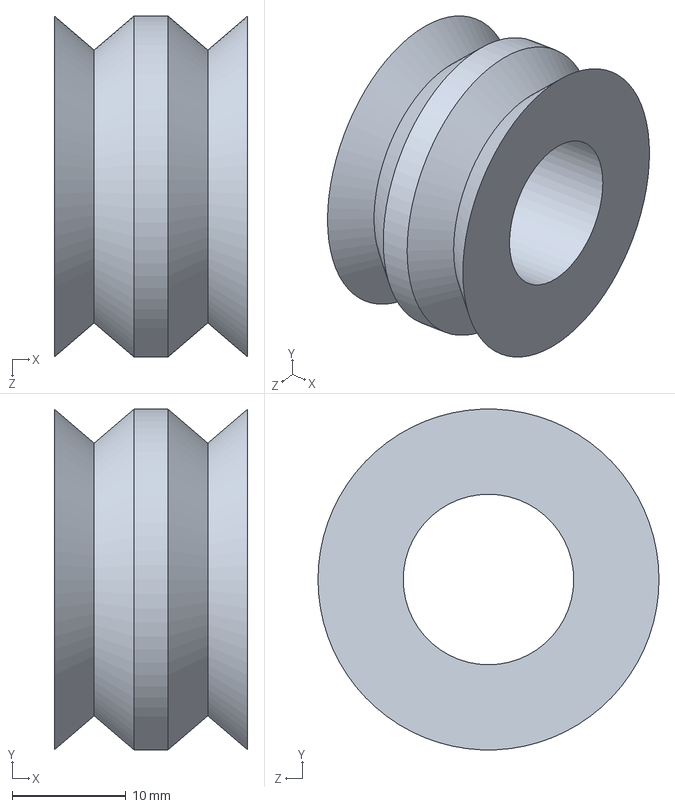
[picture p84: CAD file, 2021-10-27]
2_CAD/Konzept I/Riemenscheibe_Dummy.SLDPRT
17.0 x 30.0 x 30.0 mm
