Purdbull/Studienarbeit/2_CAD/Konzept II/PrintData/Laufrad v7.stl

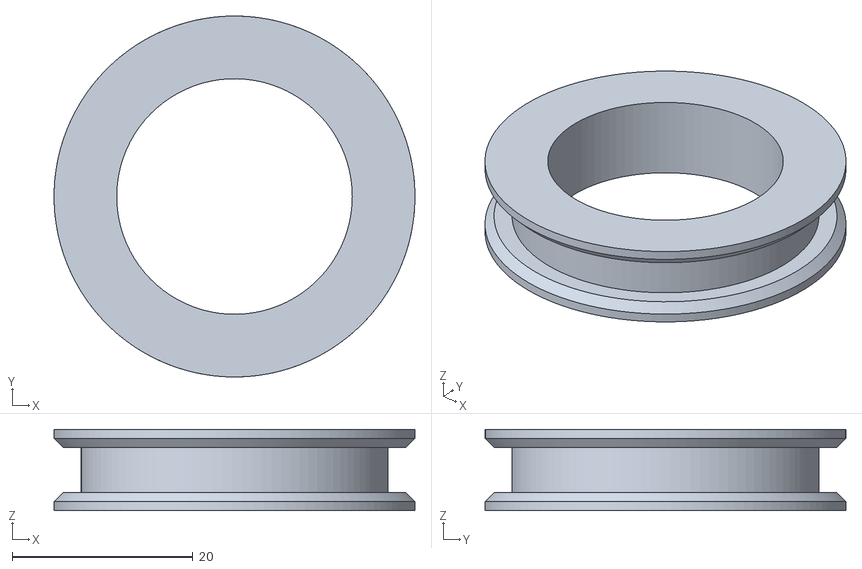
[picture p85: CAD file, 2022-03-07]
2_CAD/Konzept II/PrintData/Laufrad v7.stl
40.0 x 40.0 x 9.00
