Purdbull/Studienarbeit/2_CAD/Konzept II/Seitenteil_B_SW2021_neueMaße_neuerUnterboden.SLDPRT

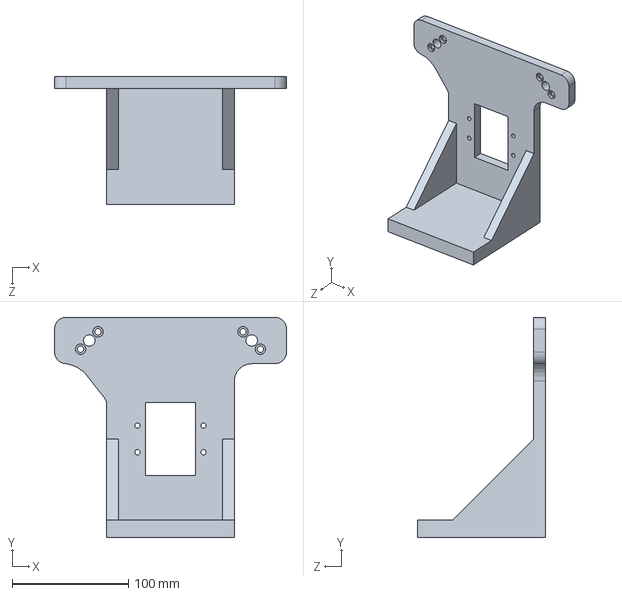
[picture p86: CAD file, 2022-02-10]
2_CAD/Konzept II/Seitenteil_B_SW2021_neueMaße_neuerUnterboden.SLDPRT
200.0 x 190.0 x 110.0 mm
