Purdbull/Studienarbeit/2_CAD/Konzept I/Steuerungsbox_dummy.SLDPRT

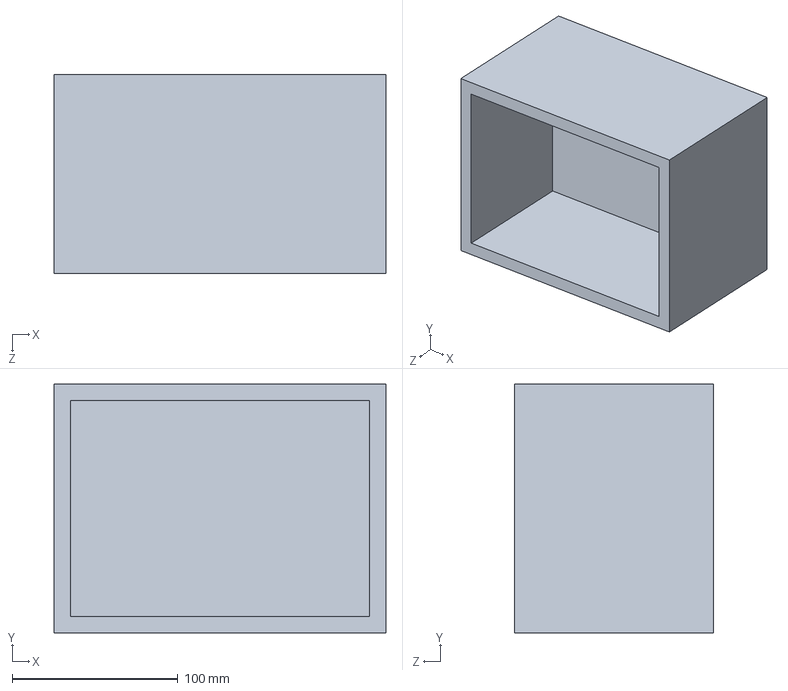
[picture p87: CAD file, 2021-10-27]
2_CAD/Konzept I/Steuerungsbox_dummy.SLDPRT
200.0 x 150.0 x 120.0 mm
