Purdbull/Studienarbeit/2_CAD/Konzept II/PrintData/Seitenteil_B_SW2021.STL

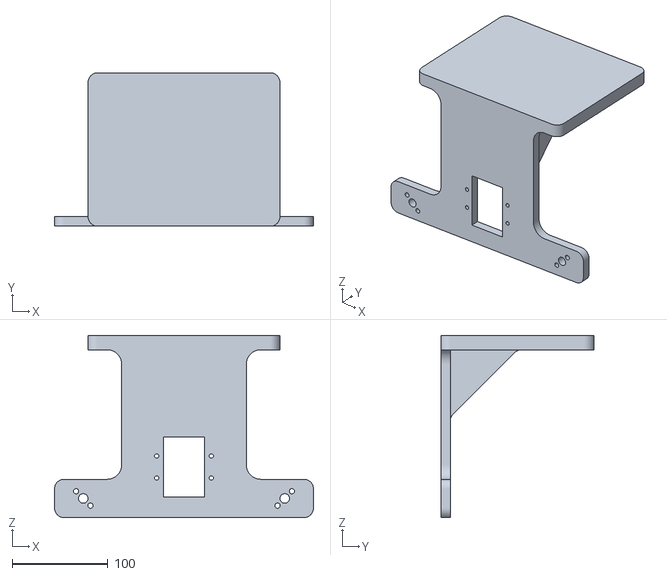
[picture p88: CAD file, 2022-01-17]
2_CAD/Konzept II/PrintData/Seitenteil_B_SW2021.STL
270.0 x 160.0 x 190.0
