Purdbull/Studienarbeit/2_CAD/Konzept I/NEMA14.STEP

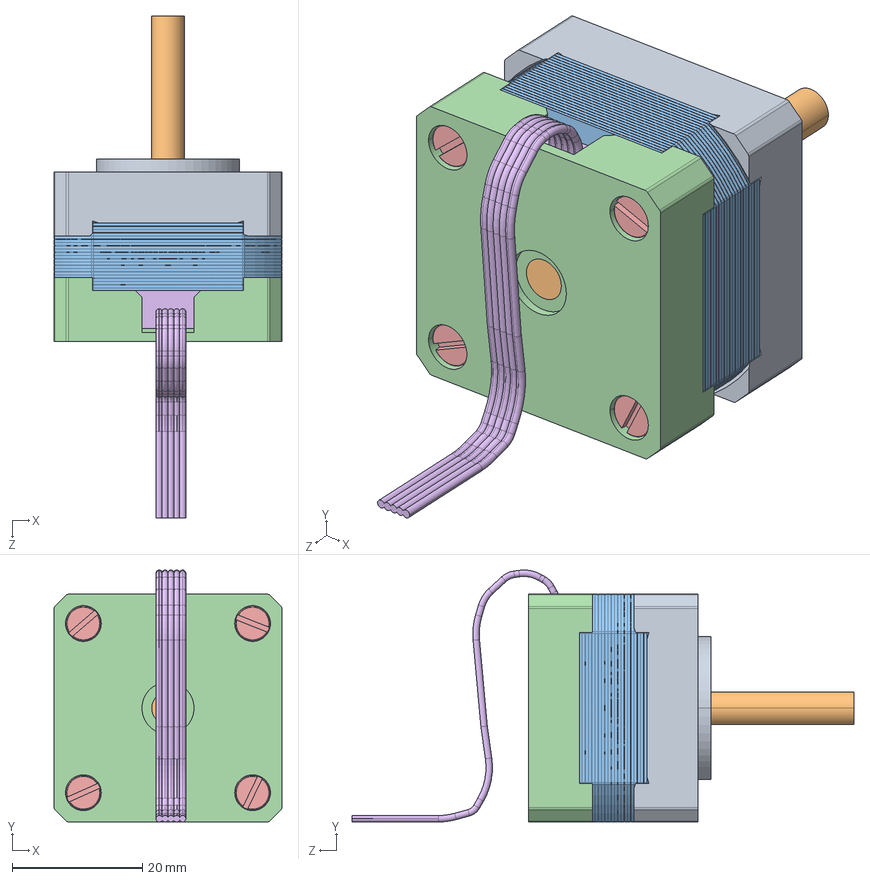
[picture p89: CAD file, 2021-10-27]
2_CAD/Konzept I/NEMA14.STEP
35.0 x 38.7 x 77.1 mm
Lagerschild_14
Welle_14
Stator_14
Kollektorschild_14
Schraube_M3x5 x 4
Connector_14
