Purdbull/Studienarbeit/2_CAD/Konzept II/PrintData/Seitenteil_B.STL

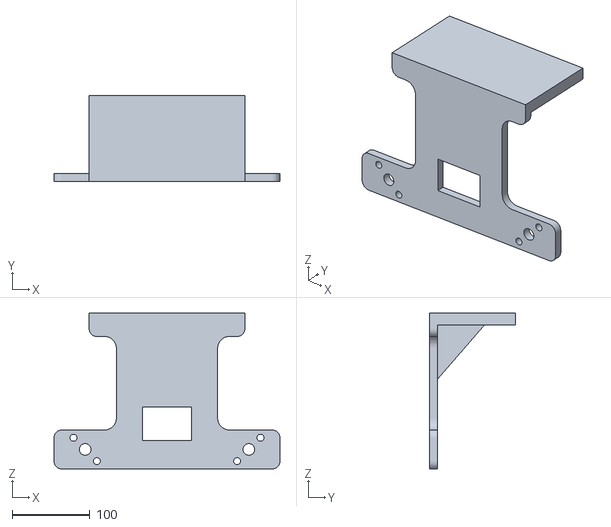
[picture p90: CAD file, 2022-01-14]
2_CAD/Konzept II/PrintData/Seitenteil_B.STL
290.0 x 110.0 x 200.0
