Purdbull/Studienarbeit/2_CAD/Konzept II/WelleZahnrad.SLDPRT

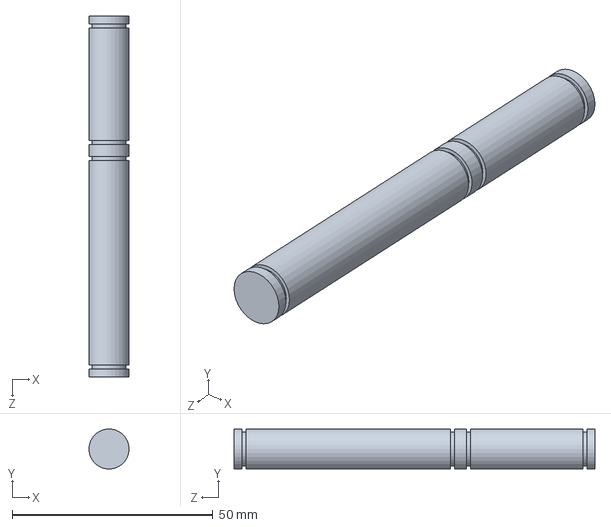
[picture p91: CAD file, 2022-02-07]
2_CAD/Konzept II/WelleZahnrad.SLDPRT
10.0 x 9.95 x 90.0 mm
