Purdbull/Studienarbeit/2_CAD/Konzept II/Wellenaufnahme.SLDPRT

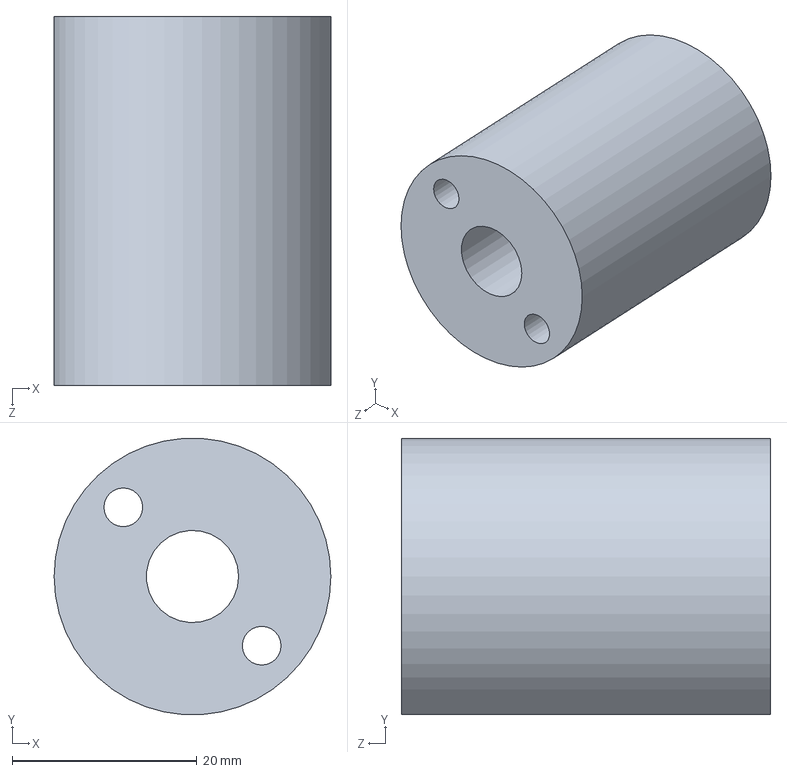
[picture p92: CAD file, 2022-01-26]
2_CAD/Konzept II/Wellenaufnahme.SLDPRT
30.0 x 29.9 x 40.0 mm
