Purdbull/Studienarbeit/2_CAD/Konzept II/Welle.SLDPRT

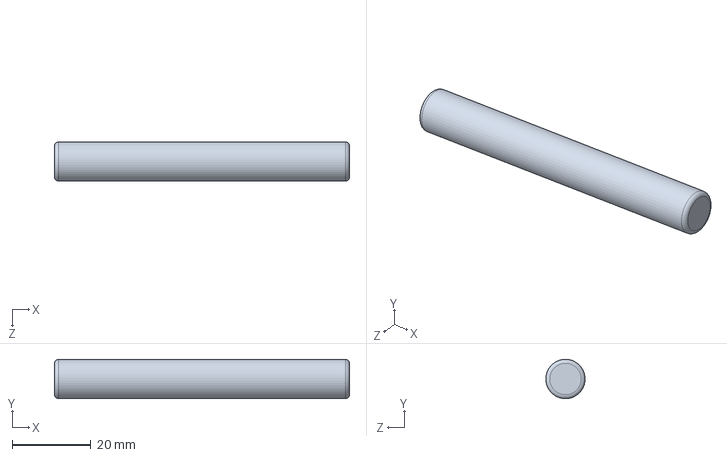
[picture p93: CAD file, 2021-11-24]
2_CAD/Konzept II/Welle.SLDPRT
75.0 x 9.99 x 9.99 mm
