Purdbull/Studienarbeit/2_CAD/Konzept II/Verbindungsdreieck.SLDPRT

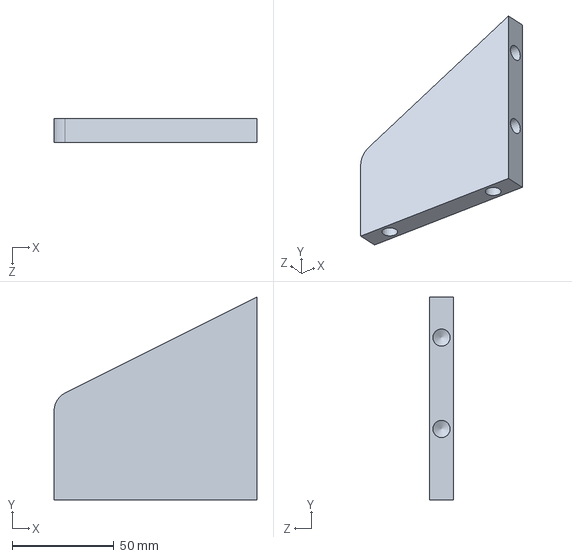
[picture p94: CAD file, 2021-11-24]
2_CAD/Konzept II/Verbindungsdreieck.SLDPRT
100.0 x 100.0 x 12.0 mm
