Purdbull/Studienarbeit/2_CAD/Konzept II/Seitenteil_A.SLDPRT

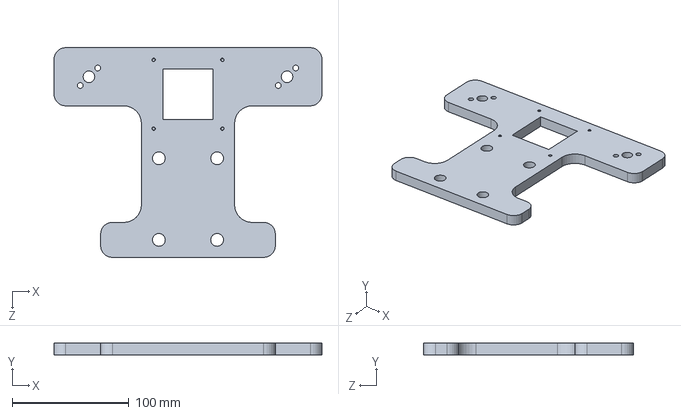
[picture p95: CAD file, 2021-11-24]
2_CAD/Konzept II/Seitenteil_A.SLDPRT
230.0 x 10.0 x 180.0 mm
