Purdbull/Studienarbeit/2_CAD/Konzept II/Laufrolle.SLDPRT

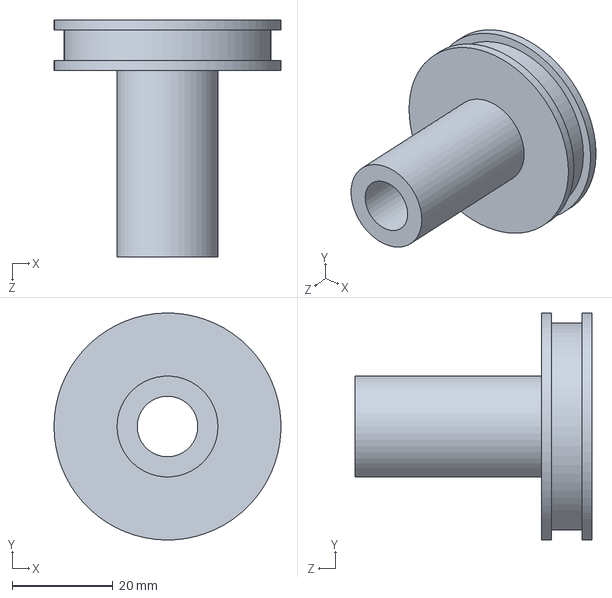
[picture p96: CAD file, 2021-11-06]
2_CAD/Konzept II/Laufrolle.SLDPRT
45.0 x 45.0 x 47.0 mm
