Purdbull/Studienarbeit/2_CAD/Konzept II/EvolventenRAd.SLDPRT

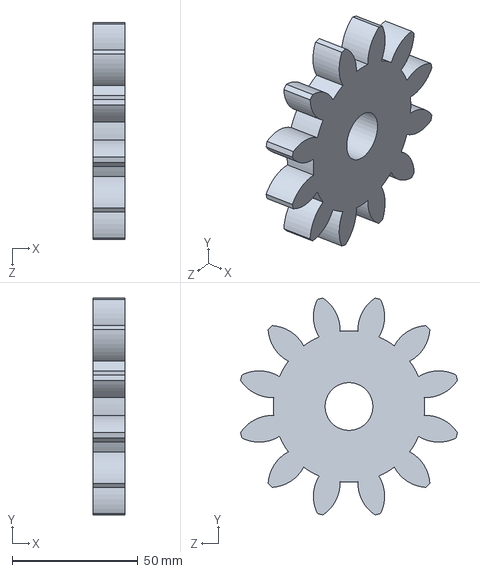
[picture p97: CAD file, 2021-11-03]
2_CAD/Konzept II/EvolventenRAd.SLDPRT
12.7 x 86.4 x 86.4 mm
