Purdbull/Studienarbeit/2_CAD/Konzept II/Schiene.SLDPRT

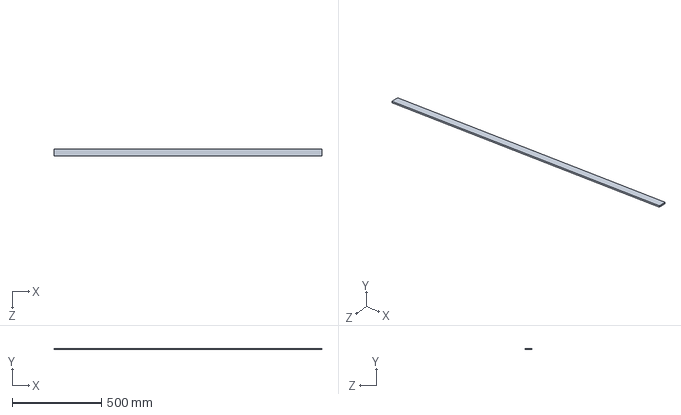
[picture p98: CAD file, 2021-11-03]
2_CAD/Konzept II/Schiene.SLDPRT
1500.0 x 7.50 x 40.0 mm
