Purdbull/Studienarbeit/2_CAD/Konzept II/Unterbodenplatte.SLDPRT

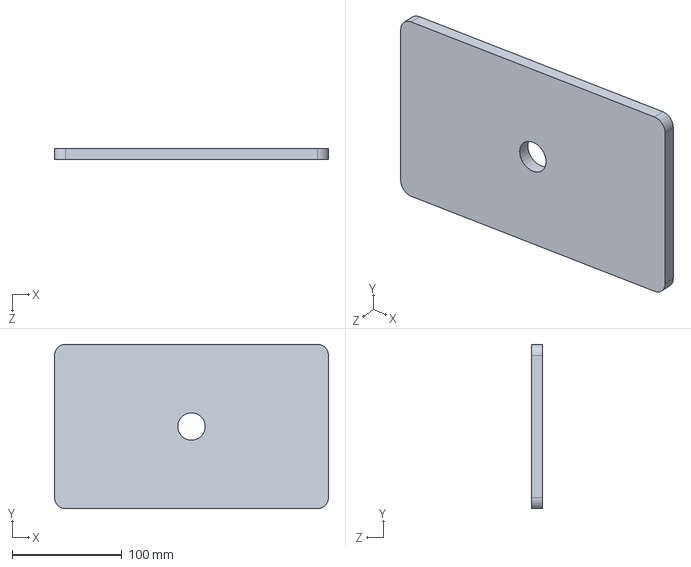
[picture p99: CAD file, 2021-10-31]
2_CAD/Konzept II/Unterbodenplatte.SLDPRT
250.0 x 150.0 x 10.0 mm
