Purdbull/Studienarbeit/2_CAD/Konzept II/Seilrolle-52-8.STEP

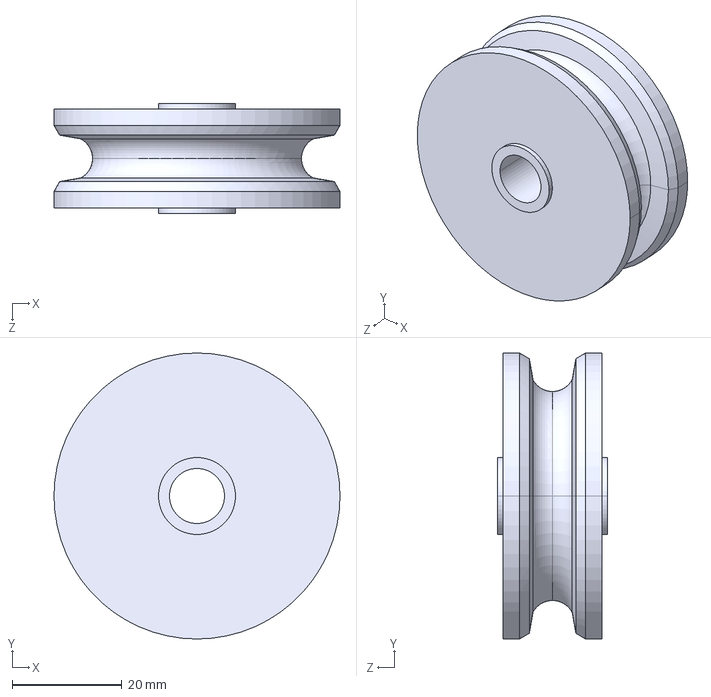
[picture p100: CAD file, 2021-10-31]
2_CAD/Konzept II/Seilrolle-52-8.STEP
52.0 x 52.0 x 20.0 mm
