Purdbull/Studienarbeit/(list of files, cad)

Other CAD files:
2_CAD/Konzept II/Getriebe/Vorlagen/SKF_6000.sldasm
2_CAD/Konzept II/STEP/reedKontaktHalter.STEP
2_CAD/Konzept II/Getriebe/Vorlagen/SKF_6000_11.sldprt
2_CAD/Konzept II/PrintData/ladevorrichtung.STL
2_CAD/Konzept II/PrintData/ZahnRiemenRad v10.stl
2_CAD/Konzept II/Seitenteil_B_SW2021_neueMaße.SLDPRT
2_CAD/Konzept II/WelleLaufrad.SLDPRT
2_CAD/Konzept II/Seitenteil_B_SW2020.SLDPRT
2_CAD/Konzept II/Motorbefestigung2.SLDPRT
2_CAD/Konzept II/Motorbefestigung.SLDPRT
2_CAD/Konzept II/Seitenteil_B.SLDPRT
2_CAD/Konzept I/NEMA14.SLDASM
2_CAD/Konzept I/NEMA14.SLDPRT
2_CAD/Konzept I/Seitenteil_B.SLDDRW
2_CAD/Konzept II/Box.STL
2_CAD/Konzept II/Getriebe/Vorlagen/ZahnradMotor v5.f3d
2_CAD/Konzept II/NEMA14.SLDASM
2_CAD/Konzept II/NEMA14.SLDPRT
2_CAD/Konzept II/PrintData/reedKontaktHalter.STL
2_CAD/Konzept II/STEP/Seitenteil_B_SW2021.STEP
2_CAD/Konzept II/STEP/reedKontaktHalter.SLDPRT
2_CAD/Konzept II/Seitenteil_A_SW2021.STL
2_CAD/Konzept II/Seitenteil_B_SW2021.SLDDRW
2_CAD/Konzept II/Seitenteil_B_SW2021.SLDPRT
2_CAD/Konzept II/Seitenteil_B_SW2021.STL
2_CAD/Konzept II/Seitenteil_B_SW2021_neueMaße.SLDDRW
2_CAD/Konzept II/Seitenteil_B_SW2021_neueMaße.STL
2_CAD/Konzept II/Triebwagen.SLDASM
2_CAD/Konzept II/Verbindungsbolzen.SLDDRW
2_CAD/Konzept II/Zeichnungen/Motorbefestigung2.SLDDRW
2_CAD/Konzept II/Zeichnungen/NEMA14.SLDDRW
2_CAD/Konzept II/Zeichnungen/Seitenteil_A.SLDDRW
2_CAD/Konzept II/Zeichnungen/Seitenteil_B_SW2021.SLDDRW
2_CAD/Konzept II/Zeichnungen/Unterbodenplatte2.SLDDRW
2_CAD/Konzept II/Zeichnungen/WelleLaufrad.SLDDRW
2_CAD/Konzept II/Zeichnungen/WelleZahnrad.SLDDRW
2_CAD/Konzept II/Zeichnungen/Wellenaufnahme.SLDDRW
2_CAD/Konzept II/boxNeu.SLDDRW
2_CAD/Konzept II/boxNeu.STL
2_CAD/Konzept II/ladevorrichtung.SLDPRT
2_CAD/Konzept II/reedKontaktHalter.SLDPRT
2_CAD/Konzept II/reedKontaktHalter.STEP
2_CAD/Konzept II/reedKontaktHalter.STL
