Purdbull/Studienarbeit/2_CAD/Konzept II/STEP/ladevorrichtung v1.png

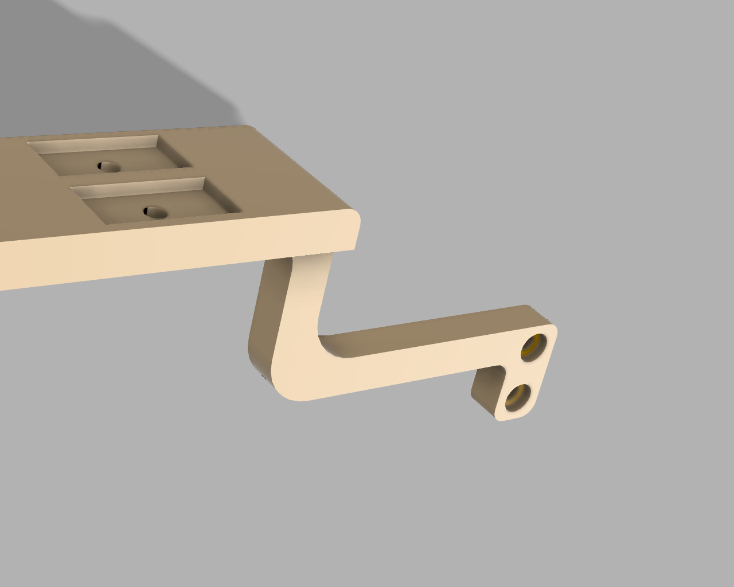
2_CAD/Konzept II/STEP/ladevorrichtung v1.png
