Purdbull/Studienarbeit/2_CAD/Konzept II/STEP/ladevorrichtung_v1_2022-May-03_04-05-07PM-000_CustomizedView29052934432.png

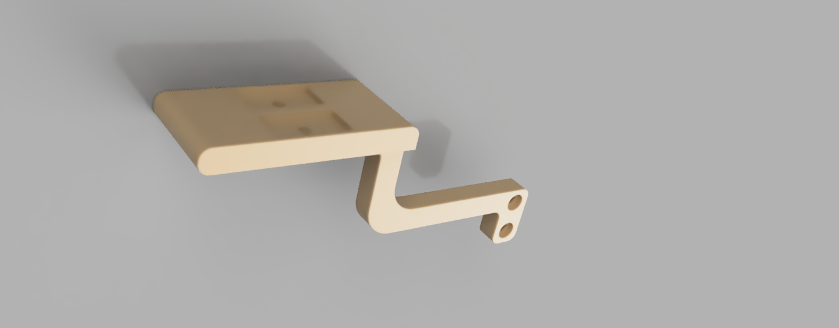
2_CAD/Konzept II/STEP/ladevorrichtung_v1_2022-May-03_04-05-07PM-000_CustomizedView29052934432.png
