Purdbull/Studienarbeit/2_CAD/Konzept II/Zeichnungen/Motorbefestigung2.pdf

E E

F F

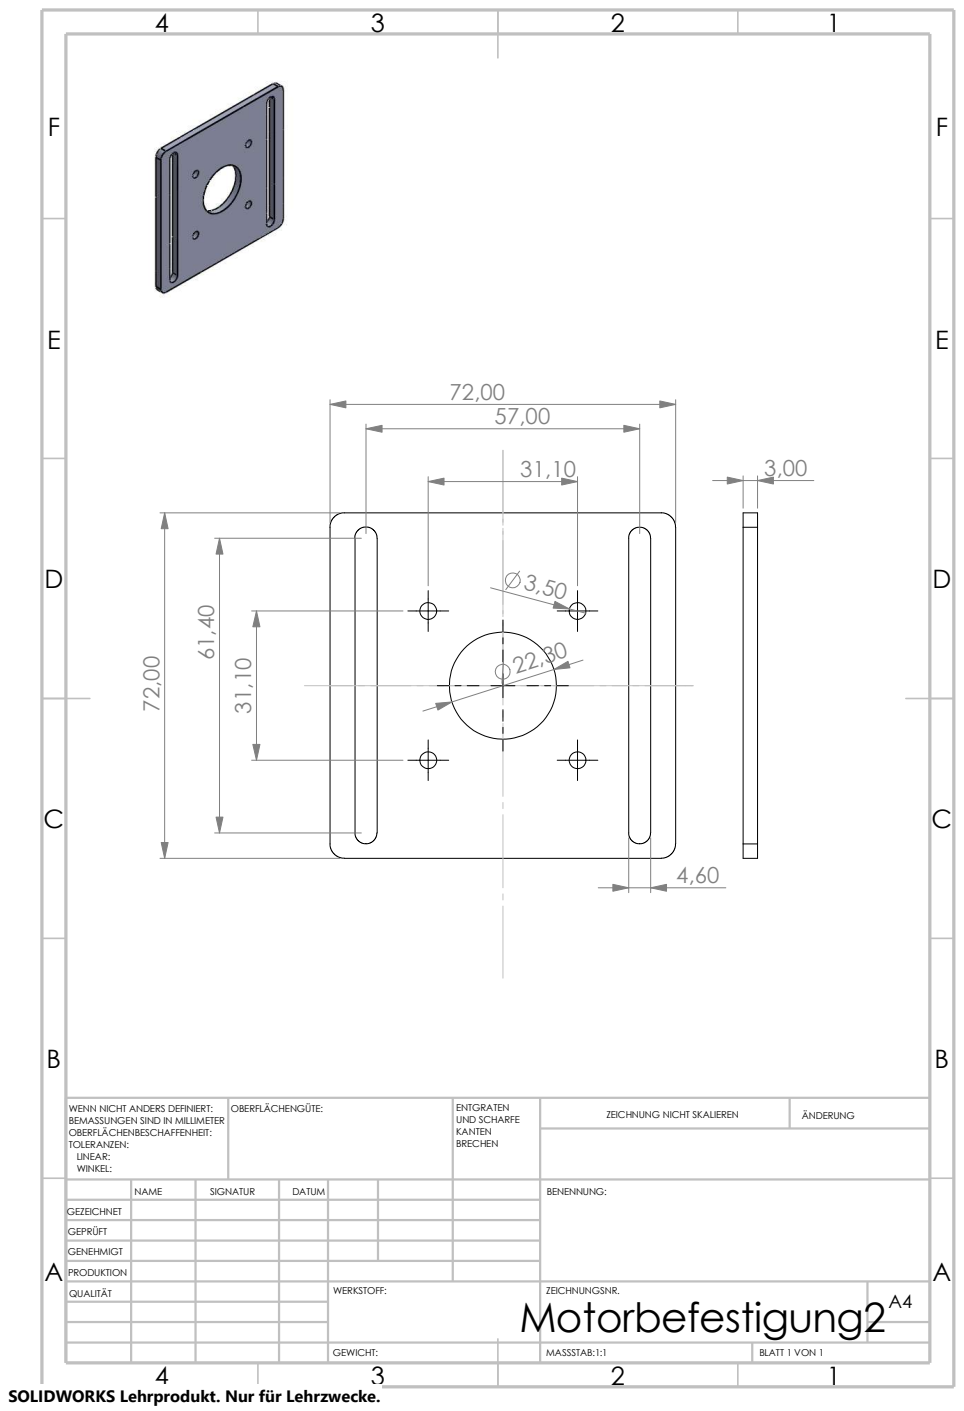
[picture p103: page 1]
PRODUKTION; GEWICHT:; Motorbefestigung2; BLATT 1 VON 1; MASSSTAB:1:1; ZEICHNUNGSNR.; ZEICHNUNG NICHT SKALIEREN; ÄNDERUNG; WERKSTOFF:; QUALITÄT; OBERFLÄCHENGÜTE:; KANTEN; UND SCHARFE; ENTGRATEN; BRECHEN

WENN NICHT ANDERS DEFINIERT:
BEMASSUNGEN SIND IN MILLIMETER
OBERFLÄCHENBESCHAFFENHEIT:
TOLERANZEN:
LINEAR:
WINKEL:

NAME | SIGNATUR | DATUM | BENENNUNG:

GEZEICHNET
GEPRÜFT
GENEHMIGT

SOLIDWORKS Lehrprodukt. Nur für Lehrzwecke.
