Purdbull/Studienarbeit/0_Projektorga/Brainstorming.pdf

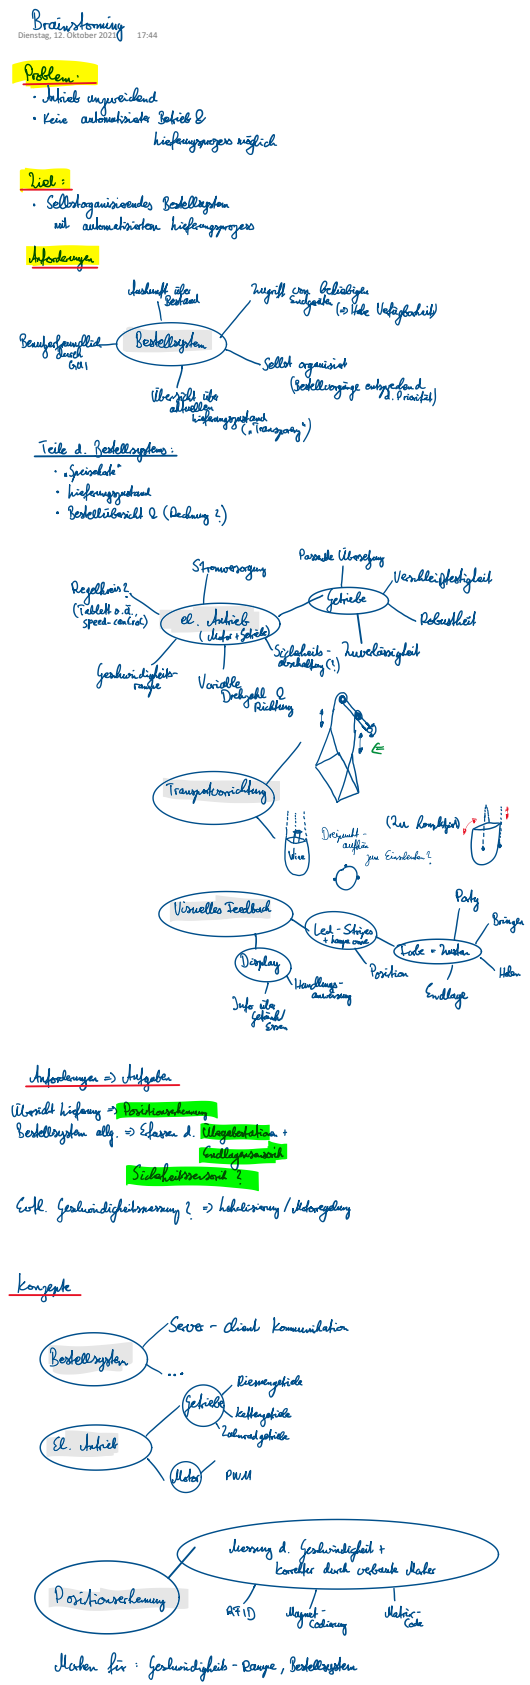
[picture p104: page 1]
Dienstag, 12. Oktober 2021
