Purdbull/Studienarbeit/2_CAD/Konzept II/Seitenteil_B_SW2021_neueMaße.pdf

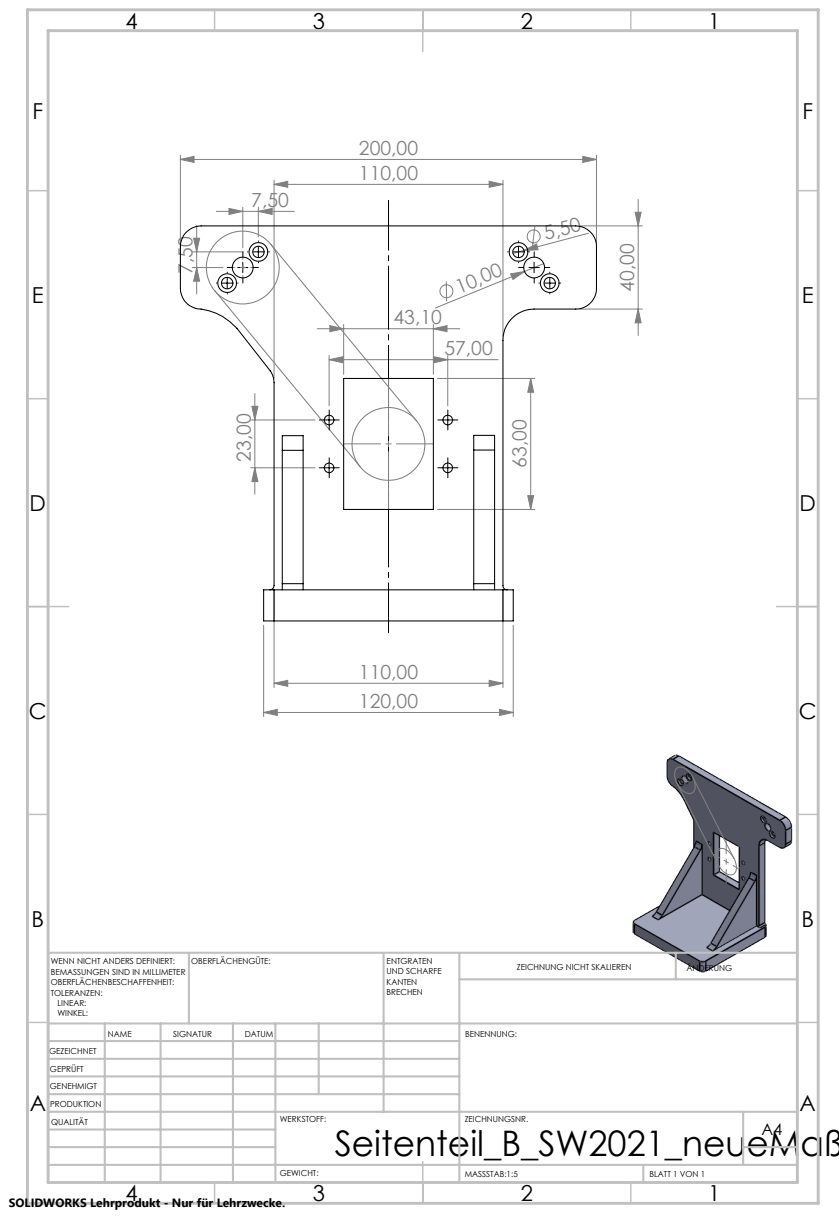
[picture p105: page 1]
MASSSTAB:1:5; BLATT 1 VON 1; ZEICHNUNG NICHT SKALIEREN; ÄNDERUNG; UND SCHARFE; WENN NICHT ANDERS DEFINIERT:; OBERFLÄCHENGÜTE:

BEMASSUNGEN SIND IN MILLIMETER
OBERFLÄCHENBESCHAFFENHEIT:
TOLERANZEN:
LINEAR:
WINKEL:

NAME | SIGNATUR | DATUM | | | | BENENNUNG:
QUALITÄT | | | | WERKSTOFF: Seitenteil_B_SW2021_neueMaße GEWICHT: | ZEICHNUNGSNR. | A4

GEZEICHNET
GEPRÜFT
GENEHMIGT
PRODUKTION

SOLIDWORKS Lehrprodukt - Nur für Lehrzwecke.
