Purdbull/Studienarbeit/2_CAD/Konzept II/Zeichnungen/boxNeu.pdf

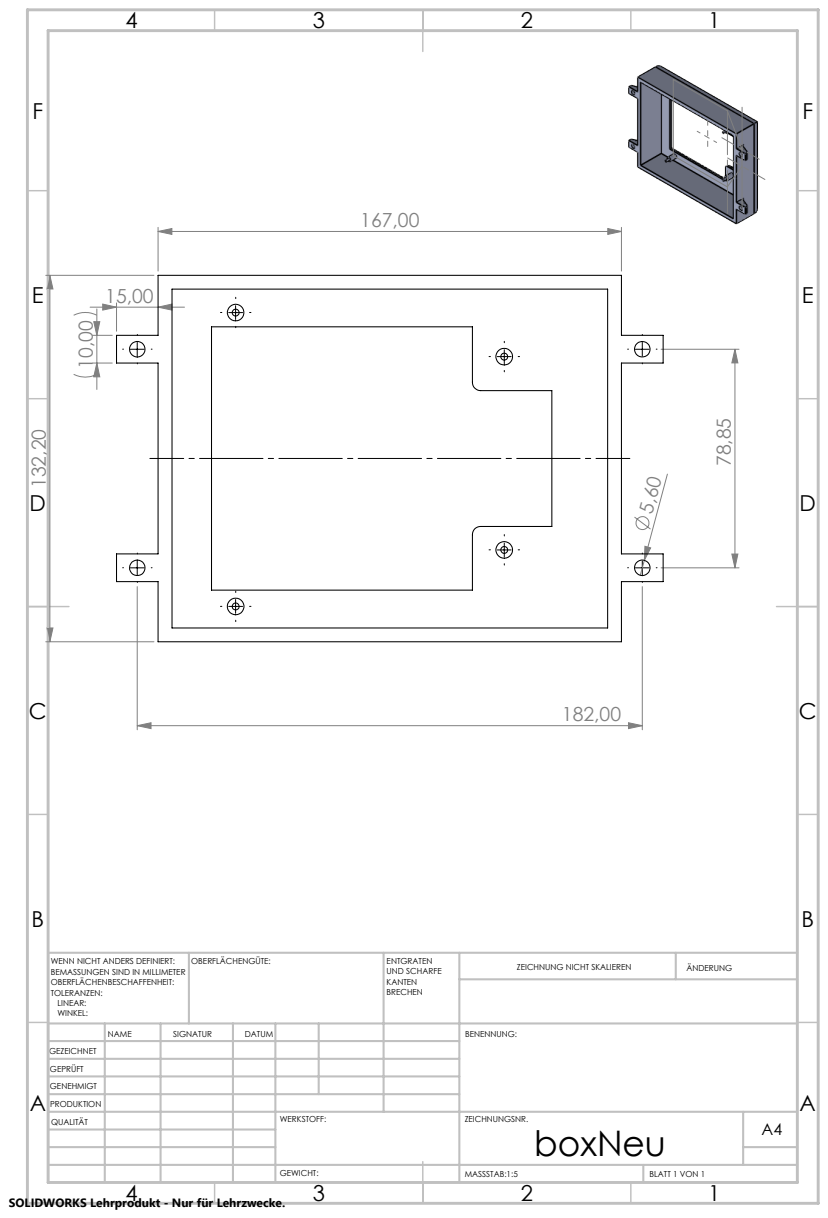
[picture p106: page 1]
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

BEMASSUNGEN SIND IN MILLIMETER
OBERFLÄCHENBESCHAFFENHEIT:
TOLERANZEN:
LINEAR:
WINKEL:

NAME | SIGNATUR | DATUM | | | | BENENNUNG:

GEZEICHNET
GEPRÜFT
GENEHMIGT
PRODUKTION
QUALITÄT | | | | WERKSTOFF: | ZEICHNUNGSNR. boxNeu GEWICHT: | A4

SOLIDWORKS Lehrprodukt - Nur für Lehrzwecke.
