Purdbull/Studienarbeit/3_Unterprogramme/stepper/trash/HighTrainStepper_FinalLib/HighTrainStepper.h

#include <Arduino.h>
#ifndef HighTrainStepper_h
#define HighTrainStepper_h

/*
// PinOut breadBoard
#define DIR 3
#define CLK 2
#define SLEEP 10
#define M0 4
#define M1 5
#define LED 9
*/

#define DIR 7
#define CLK 8
#define ENBL 5
#define M0 10
#define M1 9
#define LED 9


class Stepper {
  private:

    int targetRegVal; //target speed

    int count; //counter for ISR Prescaler,
    int acc; //accelecaration (modulo)
    bool accDone; ;
    int s;


    void dis();
    void setDir(int targetSpeed);


  public:

    Stepper();
    ~Stepper();
    void initInterrupts();
    void en();

    void linear(int targetVal, int targetAcc=50);
    void stopMode(int n);
    void isr();
    void stepMode(int mode);



};

#endif
