Purdbull/Studienarbeit/Software/software_esp/software_esp/State.cpp

#include "Arduino.h"
#include "State.h"

State::State(){
  
}

State::~State(){
  
}

int State::handle(String serverMsg){
    return ERROR_STATE;
}

int State::handle(byte arduinoMsg){
    return ERROR_STATE;
}

int State::handleWithoutParam(){
    return ERROR_STATE;
}

void State::handle(){
  
}
