Purdbull/Studienarbeit/Software/software_arduino_main/sWait.h

#include "Arduino.h"
#include "State.h"
#include "Decoder.h"

#ifndef sWait_h
#define sWait_h

/* Wait State
 * ----------------------------------------------------
 * 2 tasks:
 * - check for drive position orders
 * - evaluate received drive order
 * ----------------------------------------------------
 * change state:
 * - sDrive; when order is right and acc is sendt back
 * - sError; when order is wrong or no oder received
 */

class sWait : public State {
  public:
    sWait();
    ~sWait();
    Decoder* jarvis;
    void handle();
    void clearSerialBuffer();
    int handle(byte);
    int handleWithoutParam();
};

#endif
