Purdbull/Studienarbeit/(commit log)

2021-10-20 Morphologischer Bierkasten begonnen
    [MorphologischerBierkasten.xlsx]
2021-10-26 schrittmotor auswahl
    [AuswahlSchrittmotor.xlsx]
2021-10-28 Nema 17-04 Motor CAD eingefügt
    [Nema 17-04.SLDPRT, Seitenteil_A.SLDPRT, Triebwagen.SLDASM]
2021-10-29 Bestellübersicht und Orga
    [AuswahlSchrittmotor.xlsx, Bestellübersicht.xlsx, MorphologischerBierkasten.xlsx, NEMA14.SLDASM, NEMA14.SLDDRW, NEMA14.SLDPRT, NEMA14.STEP, Riemenscheibe_Dummy.SLDPRT]
2021-10-31 CAD Konzept II
    [Laurfollen .xlsx, NEMA14.SLDASM, NEMA14.SLDDRW, NEMA14.SLDPRT, NEMA14.STEP, Nema 17-04.SLDPRT, Riemenscheibe_Dummy.SLDPRT, Schiene.SLDPRT]
2021-11-03 cad wetier
    [EvolventenRAd.SLDPRT, LaufrolleRiemenrad.SLDPRT, Riemenrad_treibend.SLDPRT, Schiene.SLDPRT, Triebwagen.SLDASM]
2021-11-05 Maße Riemengetriebe aktualisiert
    Treibend = 87,5
    getriebe = 35
    [LaufrolleRiemenrad.SLDPRT, Riemenrad_treibend.SLDPRT, Triebwagen.SLDASM]
2021-11-06 show goes on und STEP
    [Laufrolle.SLDPRT, Motorbefestigung.SLDPRT, Seitenteil_A.SLDPRT, Seitenteil_B.SLDDRW, Seitenteil_B.SLDPRT, Triebwagen.SLDASM, Triebwagen.STEP, Verbindungsdreieck.SLDPRT]
2021-11-08 Treibrad Zahnfläche erstellt
    [30mm_htd_5m.stp, 81mm_htd_5m.stp, LaufrolleRiemenrad.SLDPRT, Riemenrad_treibend.SLDPRT, Riemenrad_treibend_neu.SLDPRT, Riemenscheibe_Dummy.SLDPRT, Triebwagen.SLDASM, Verbindungsdreieck.SLDPRT]
2021-11-10 Bestellübersicht online
    [Bestellübersicht.xlsx]
2021-11-12 pipapo... Paar Datenblätter und sein Bewertungsbogen eingefügt
    [Bewertung_Projekt_Studien_Bachelor.xlsx]
2021-11-14 driverTest & testat 2
    [KonzepteEntscheidungen.xlsx]
2021-11-15 Gesamtübersicht RoadMap
    [RoadMap.xlsx]
2021-11-16 Theorie Ultraschallmessung
    [RoadMap.xlsx]
2021-11-16 Roadmap und Rausschrieb
    [RoadMap.xlsx]
2021-11-18 Schrittmotoren - so good so far (and it's still working)
    [MorphologischerBierkasten.xlsx]
2021-11-19 Schrittmotor Theorie fertig und Schnittstellenkonzept fertig
2021-11-22 Kollisionsvermeidung done
    [30mm_htd_5m.stp, 81mm_htd_5m.stp, LaufradVorlage v1.stl, LaufradVorlage.f3d, LaufradVorlage.step, LaufrolleRiemenrad.SLDPRT, Riemenrad_treibend.SLDPRT, Riemenrad_treibend_neu.SLDPRT]
2021-11-22 update getriebe Fusion
    [Laufrad v6.step, Laufrad v6.stl, LaufradVorlage v1.stl, LaufradVorlage.f3d, LaufradVorlage.step, ZahnRiemenRad v3.step, ZahnradMotor v2.step, ZahnradProfilVorlage v5.f3d]
2021-11-22 dreieck seitenteil wellenaufnahme
    [Seitenteil_A.SLDPRT, Seitenteil_A.STEP, Seitenteil_B.SLDPRT, Triebwagen.SLDASM, Verbindungsdreieck.SLDPRT, Wellenaufnahme.SLDPRT, Wellenaufnahme.STEP, ZahnRiemenRad v3.SLDPRT]
2021-11-24 step update
    [Laufrad v6.step, ZahnRiemenRad v6.step, ZahnradMotor v3.step]
2021-11-24 baugruppe update
    [Seitenteil_A.SLDPRT, Seitenteil_B.SLDPRT, Triebwagen.SLDASM, Verbindungsdreieck.SLDPRT, Welle.SLDPRT]
2021-11-24 getriebe fertig CAD
    [Triebwagen.SLDASM, Welle.SLDPRT]
2021-11-24 Triebwagen STEP und Meeting Humm
    [Triebwagen.SLDASM, Triebwagen.STEP]
2021-11-25 getriebe Umsetzung und Lager CAD60000
    [RoadMap.xlsx, Triebwagen.STEP]
2021-11-25 lager neu
    [LaufrolleRiemenrad.SLDPRT, SKF_6000.stp]
2021-11-25 Langloch und Kugellager fertig
    [Motorbefestigung.SLDPRT, Motorbefestigung.STEP, Triebwagen.STEP, Triebwagen_V2.SLDASM]
2021-12-10 arduino driver sketch und energiekonvertierung
2021-12-16 Entwurf Motorsteuerung
2021-12-16 vor meeting
    [RoadMap.xlsx]
2021-12-17 Motorsteuerung done
2022-01-13 Export Laufrad
    [Laufrad_Version6.f3d, Laufrollen .xlsx, reg26a-drill.dxf]
2022-01-14 neues Seitenteil
    [Seitenteil_B.SLDPRT]
2022-01-14 Ende Gelände
    [Seitenteil_B.SLDPRT, Seitenteil_B.STL]
2022-01-17 SeitenteilB fertig
    [Seitenteil_B_SW2020.SLDDRW, Seitenteil_B_SW2020.SLDPRT, Seitenteil_B_SW2021.SLDDRW, Seitenteil_B_SW2021.SLDPRT, Seitenteil_B_SW2021.STEP, Seitenteil_B_SW2021.STL]
2022-01-24 Schaltplan update
    [Laufrad v6.step, Laufrad v6.stl, LaufradVorlage v1.stl, LaufradVorlage.f3d, LaufradVorlage.step, Laufrad_Version6.f3d, Motorbefestigung.STEP, Seitenteil_A.SLDPRT]
2022-02-07 Meeting Weickgenannt
    [WelleLaufrad.SLDDRW, WelleLaufrad.SLDPRT, WelleZahnrad.SLDDRW, WelleZahnrad.SLDPRT]
2022-02-08 added bom for soldering
    [BOM_Studienarbeit_2022-02-08.csv]
2022-02-14 neue zeichnung
    [Seitenteil_B_SW2021.SLDDRW, Seitenteil_B_SW2021.SLDPRT, Seitenteil_B_SW2021.STEP, Seitenteil_B_SW2021.STL, Seitenteil_B_SW2021_neueMaße.STEP]
2022-02-17 added uart tests
2022-02-22 Ende Dienstag
    [Unterbodenplatte2.SLDDRW, Unterbodenplatte2.SLDPRT, Verbindungsbolzen.SLDDRW, Verbindungsbolzen.SLDPRT]
2022-02-25 box und zweites Seitenteil
    [Box.SLDPRT, Box.STL, Seitenteil_A_SW2021.SLDPRT, Seitenteil_A_SW2021.STL]
2022-03-07 Meeting Presentation
    [Verbindungsbolzen.SLDDRW]
2022-03-09 began implementing error handling
    [Decoder.cpp, Decoder.h, EndState.cpp, ErrorState.cpp, ErrorState.h, IdleState.cpp, PositionState.cpp, PositionState.h]
2022-03-09 created battery measure master
2022-03-10 created and prototyped new statemaschine for the main arduino
2022-03-10 created server and finished prototyping arduino state maschine
2022-03-17 Interrupt Service Routine neu geschrieben, stable
    [motorCalc.xlsx]
2022-03-17 Modulo Overflow bug fixed
    [motorCalc.xlsx]
2022-03-22 finally FIXED this shitty error!!!
    [State.cpp, State.h, StateMaschine.cpp, sIdle.cpp, sIdle.h, software_arduino_main.ino]
2022-04-07 StepperScript Finally done
2022-04-07 working with ultrasonic
2022-04-13 bissl geschrieben und grundlagen wieder reingemacht
2022-04-20 studi bissl geworked am motor unso
2022-04-21 motor library fixed
    [motorCalc.xlsx]
2022-04-27 maybe fixed isr thing
    [Drivehandler.cpp, Drivehandler.h, Fahrmethodentest.ino, HighTrainStepper.cpp, HighTrainStepper.h]
2022-04-27 Motor Lib Teil 1
2022-04-29 doku motor library
2022-04-29 doku motor lib
2022-04-30 motor lib done
2022-05-03 ladevorrichtung CAD
    [ladevorrichtung.SLDPRT, ladevorrichtung.STEP]
2022-05-11 Doku Jan done --> Alles überarbeitet und Ergebisteil
