Purdbull/Studienarbeit/(notices)

Notices in the files:
2_CAD/Konzept II/Getriebe/SKF_6000.stp:
FILE_NAME( 'p:/temp/worker_34/temp/exporttempdir_3476_533_bLnke/format_0/SKF_6000.stp', '2021-11-25T21:03:19', ( 'License CC BY-ND 4.0' ), ( 'CADENAS' ), ' ', 'PARTsolutions', ' ' );
